Wojtekb30/ElectroChessboard/README.md

# ElectroChessboard
Electronic chessboard
