Wojtekb30/ElectroChessboard/3Dmodels/chessicons1.pdf

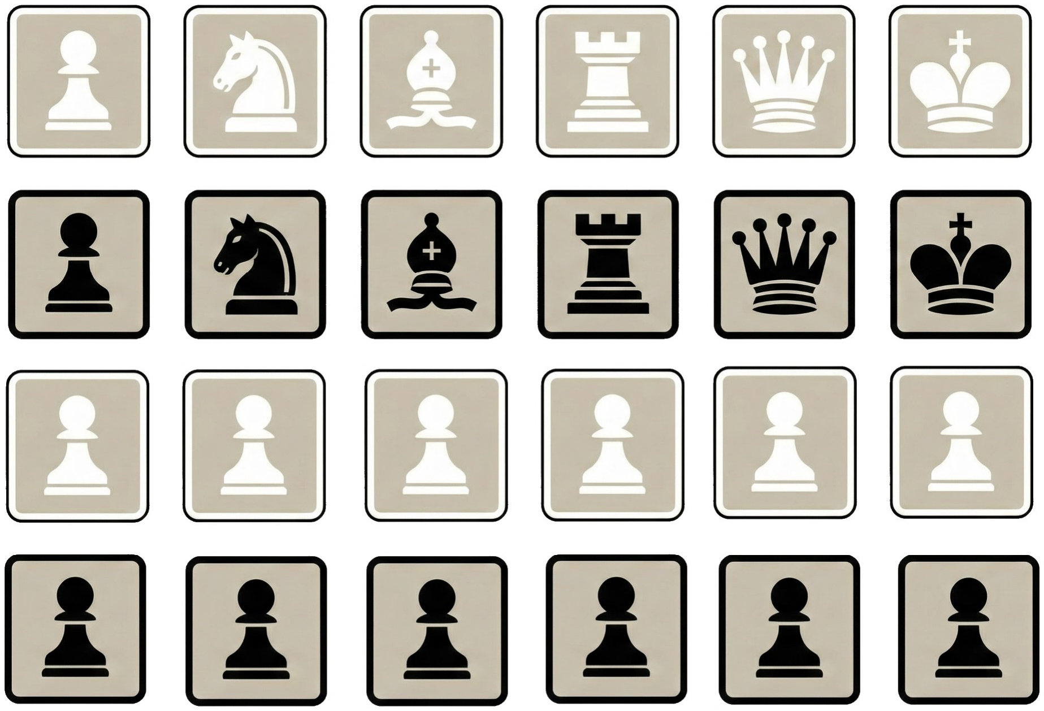
[picture p1: figure]
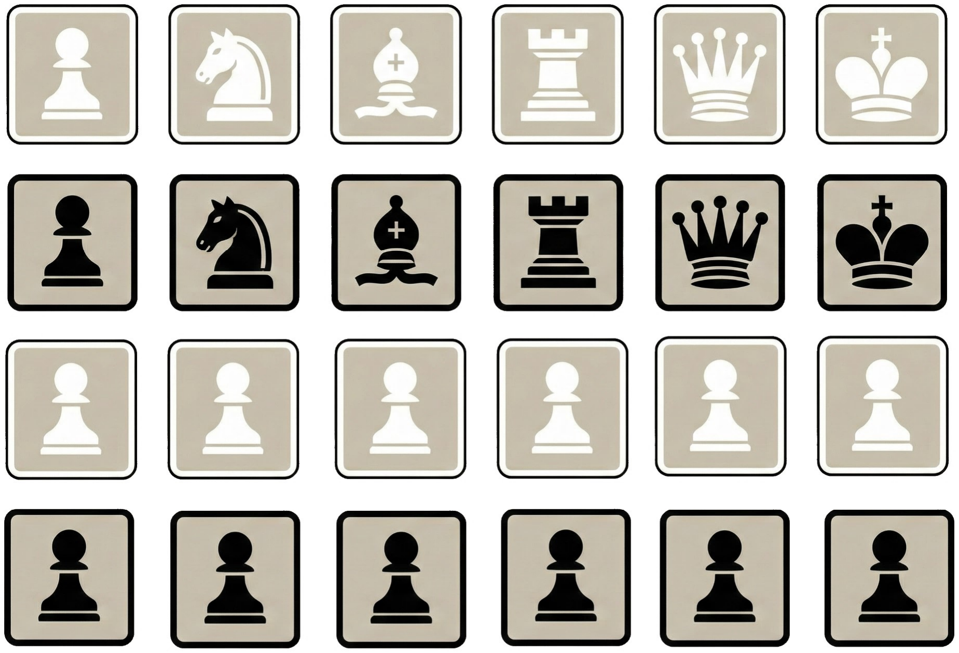
[picture p2: figure]
