Wojtekb30/ElectroChessboard/Components/PinMap2560big_Rev2.png

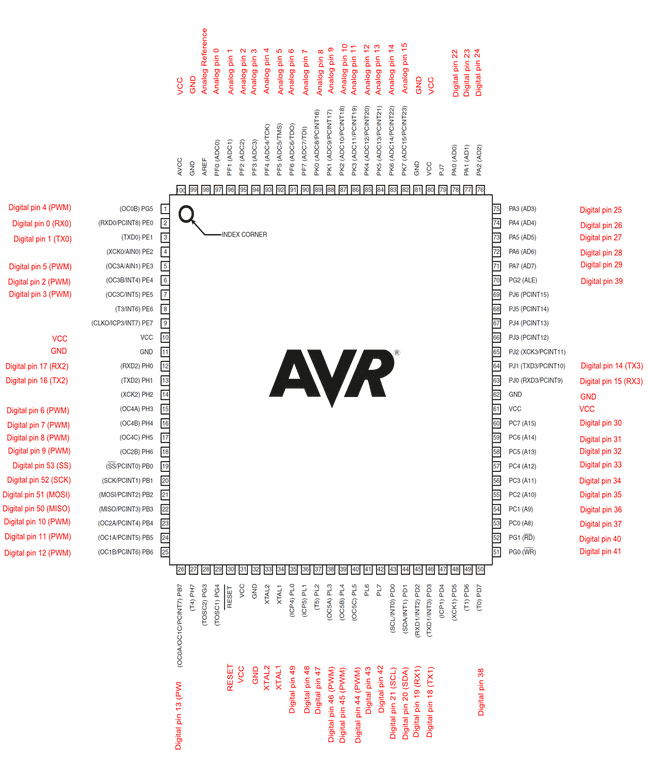
Components/PinMap2560big_Rev2.png
