Wojtekb30/ElectroChessboard/3Dmodels/16pieces1.stl

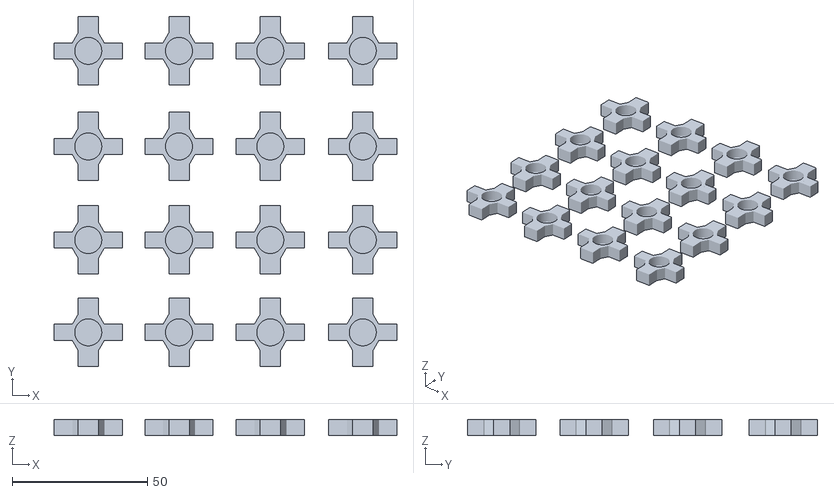
[picture p4: CAD file, 2026-01-05]
3Dmodels/16pieces1.stl
126.9 x 129.5 x 6.00
