Wojtekb30/ElectroChessboard/3Dmodels/SDcardHolderTop1.3mf

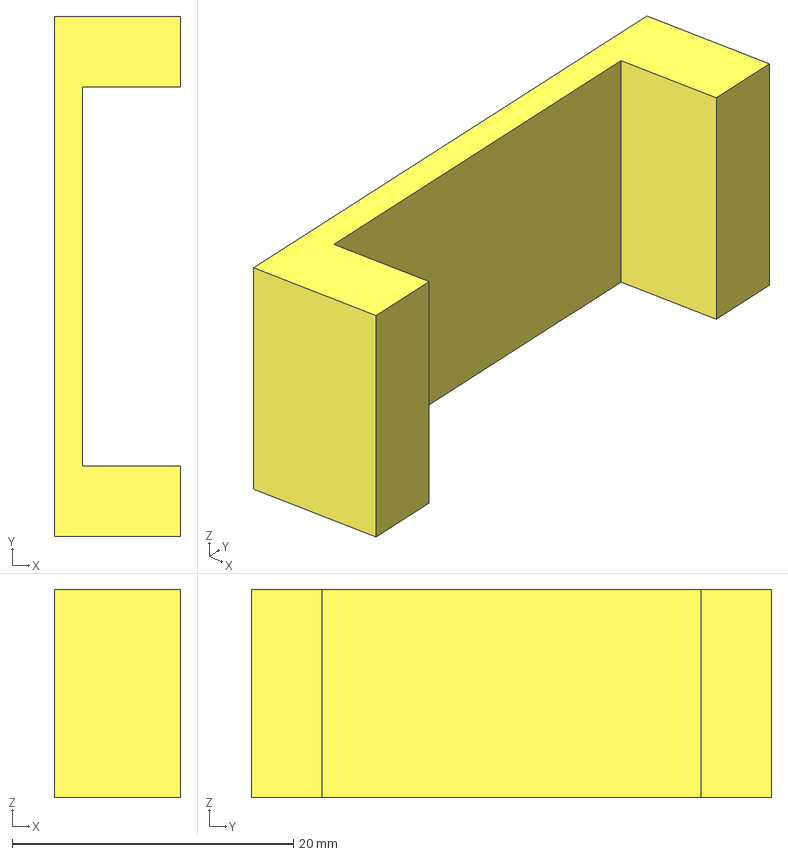
[picture p5: CAD file, 2026-01-05]
3Dmodels/SDcardHolderTop1.3mf
9.00 x 37.0 x 14.8 mm
