Wojtekb30/ElectroChessboard/3Dmodels/BoardTop1.stl

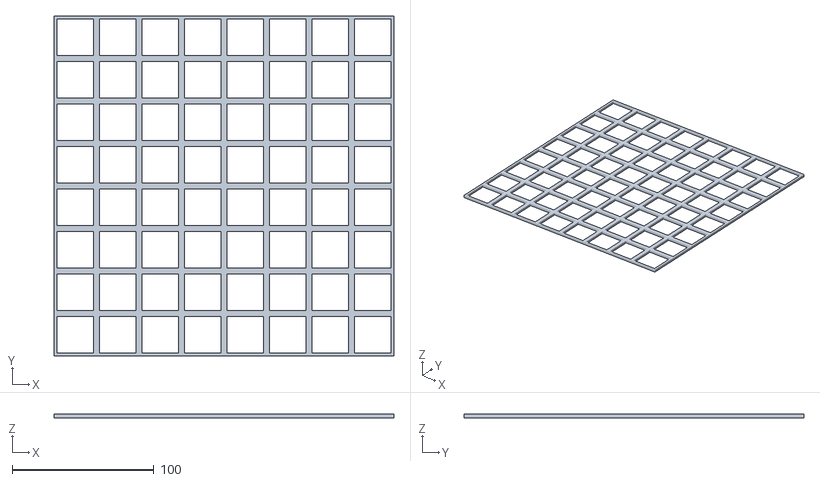
[picture p6: CAD file, 2026-01-05]
3Dmodels/BoardTop1.stl
240.0 x 240.0 x 2.50
