Wojtekb30/ElectroChessboard/3Dmodels/Piece1.3mf

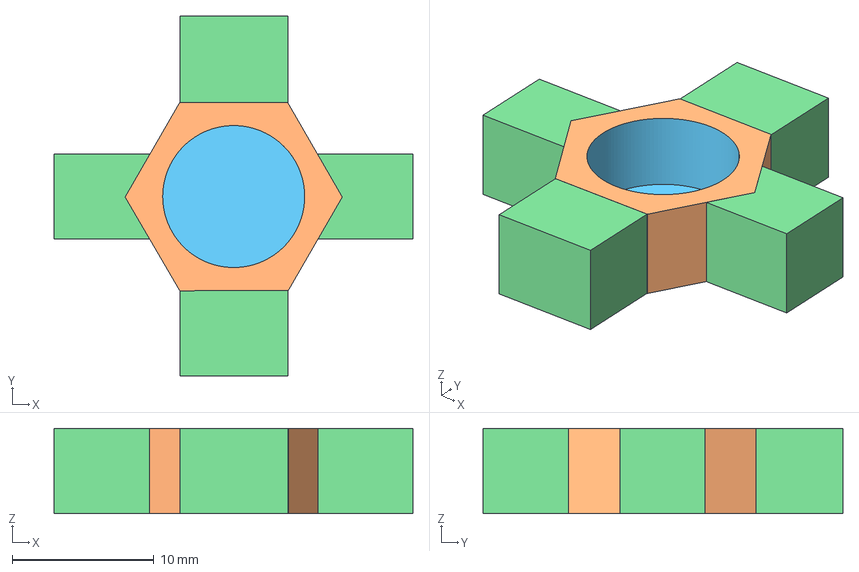
[picture p7: CAD file, 2026-01-05]
3Dmodels/Piece1.3mf
25.3 x 25.4 x 6.00 mm
