Wojtekb30/ElectroChessboard/3Dmodels/Board1.stl

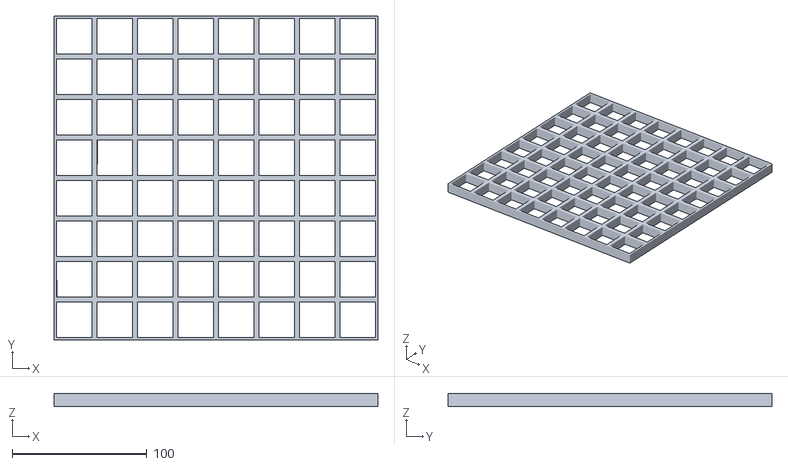
[picture p8: CAD file, 2026-01-03]
3Dmodels/Board1.stl
240.0 x 240.0 x 10.00
