Wojtekb30/ElectroChessboard/3Dmodels/BoardBase1.3mf

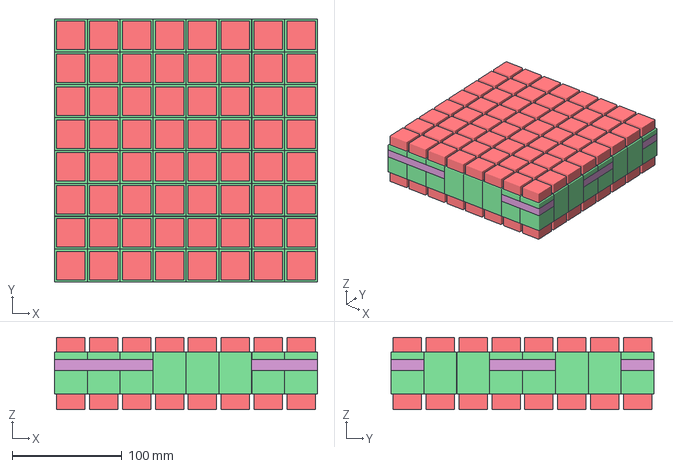
[picture p9: CAD file, 2026-01-03]
3Dmodels/BoardBase1.3mf
240.0 x 240.0 x 65.8 mm
