Wojtekb30/ElectroChessboard/(list of files, cad)

Other CAD files:
3Dmodels/Piece1.stl
3Dmodels/SDcardHolderTop1.stl
