Wojtekb30/ElectroChessboard/ElectroChessboard1/ElectroChessboard1.kicad_pcb

## KiCad design ElectroChessboard1/ElectroChessboard1.kicad_pcb (2025-12-19)

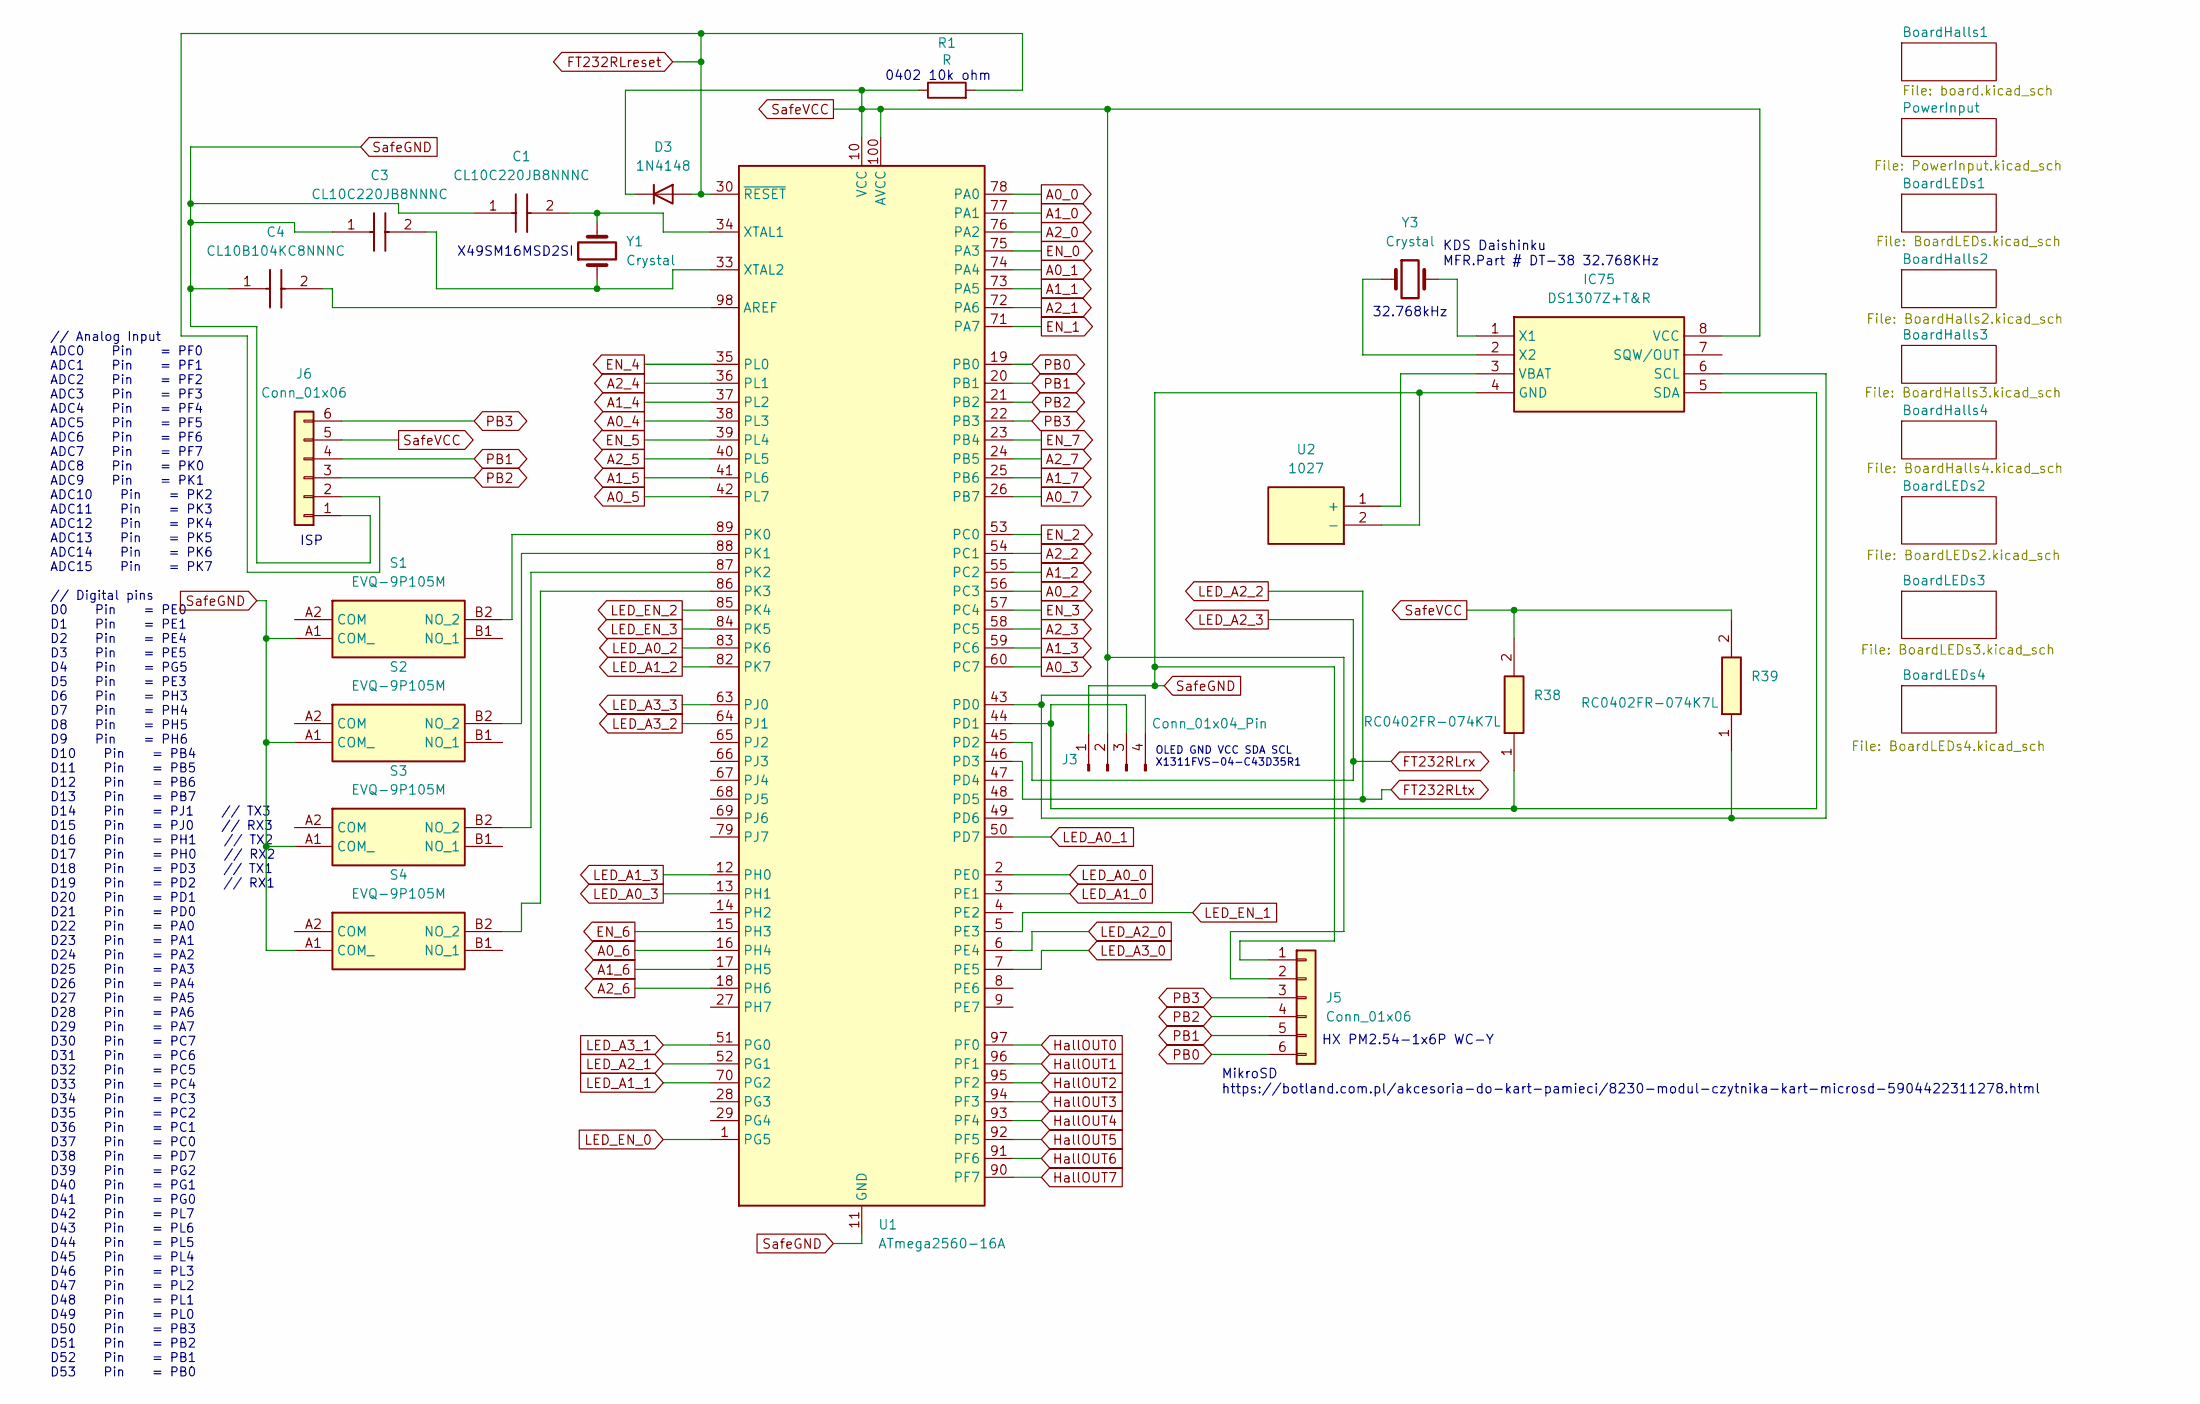
[picture p10: schematic ElectroChessboard1.kicad_sch, ElectroChessboard]

Parts:
C1, C3: CL10C220JB8NNNC; CAPC1608X90N; Mouser Part Number 187-CL10C220JB8NNNC
C4: CL10B104KC8NNNC; CAPC1608X90N; Mouser Part Number 187-CL10B104KC8NNNC
D3: 1N4148; D_SOD-123
IC75: DS1307Z+T&R; SOIC127P600X175-8N; Mouser Part Number 700-DS1307ZT&R
J3: Conn_01x04_Pin; PinSocket_1x04_P1.27mm_Vertical_SMD_Pin1Right
J5: Conn_01x06; PinSocket_1x06_P2.54mm_Horizontal
J6: Conn_01x06; PinSocket_1x06_P2.00mm_Vertical_SMD_Pin1Right
R1: R; R_0402_1005Metric
R38, R39: RC0402FR-074K7L; RESC1005X40N; Manufacturer_Part_Number RC0402FR-074K7L; Mouser Part Number 603-RC0402FR-074K7L
S1, S2, S3, S4: EVQ-9P105M; EVQ9P105M; Mouser Part Number 667-EVQ-9P105M
U1: ATmega2560-16A; TQFP-100_14x14mm_P0.5mm
U2: 1027; Mouser Part Number 534-1027
Y1: Crystal; Crystal_SMD_HC49-SD
Y3: Crystal; Crystal_C38-LF_D3.0mm_L8.0mm_Vertical

Connections:
A0_0: U1.78 (PA0); also elsewhere on the board
A0_1: U1.74 (PA4); also elsewhere on the board
A0_2: U1.56 (PC3); also elsewhere on the board
A0_3: U1.60 (PC7); also elsewhere on the board
A0_4: U1.38 (PL3); also elsewhere on the board
A0_5: U1.42 (PL7); also elsewhere on the board
A0_6: U1.16 (PH4); also elsewhere on the board
A0_7: U1.26 (PB7); also elsewhere on the board
A1_0: U1.77 (PA1); also elsewhere on the board
A1_1: U1.73 (PA5); also elsewhere on the board
A1_2: U1.55 (PC2); also elsewhere on the board
A1_3: U1.59 (PC6); also elsewhere on the board
A1_4: U1.37 (PL2); also elsewhere on the board
A1_5: U1.41 (PL6); also elsewhere on the board
A1_6: U1.17 (PH5); also elsewhere on the board
A1_7: U1.25 (PB6); also elsewhere on the board
A2_0: U1.76 (PA2); also elsewhere on the board
A2_1: U1.72 (PA6); also elsewhere on the board
A2_2: U1.54 (PC1); also elsewhere on the board
A2_3: U1.58 (PC5); also elsewhere on the board
A2_4: U1.36 (PL1); also elsewhere on the board
A2_5: U1.40 (PL5); also elsewhere on the board
A2_6: U1.18 (PH6); also elsewhere on the board
A2_7: U1.24 (PB5); also elsewhere on the board
EN_0: U1.75 (PA3); also elsewhere on the board
EN_1: U1.71 (PA7); also elsewhere on the board
EN_2: U1.53 (PC0); also elsewhere on the board
EN_3: U1.57 (PC4); also elsewhere on the board
EN_4: U1.35 (PL0); also elsewhere on the board
EN_5: U1.39 (PL4); also elsewhere on the board
EN_6: U1.15 (PH3); also elsewhere on the board
EN_7: U1.23 (PB4); also elsewhere on the board
FT232RLreset: D3.2 (A), J6.2, R1.2, U1.30 (~RESET); also elsewhere on the board
FT232RLrx: U1.45 (PD2); also elsewhere on the board
FT232RLtx: U1.46 (PD3); also elsewhere on the board
HallOUT0: U1.97 (PF0); also elsewhere on the board
HallOUT1: U1.96 (PF1); also elsewhere on the board
HallOUT2: U1.95 (PF2); also elsewhere on the board
HallOUT3: U1.94 (PF3); also elsewhere on the board
HallOUT4: U1.93 (PF4); also elsewhere on the board
HallOUT5: U1.92 (PF5); also elsewhere on the board
HallOUT6: U1.91 (PF6); also elsewhere on the board
HallOUT7: U1.90 (PF7); also elsewhere on the board
LED_A0_0: U1.2 (PE0); also elsewhere on the board
LED_A0_1: U1.50 (PD7); also elsewhere on the board
LED_A0_2: U1.83 (PK6); also elsewhere on the board
LED_A0_3: U1.13 (PH1); also elsewhere on the board
LED_A1_0: U1.3 (PE1); also elsewhere on the board
LED_A1_1: U1.70 (PG2); also elsewhere on the board
LED_A1_2: U1.82 (PK7); also elsewhere on the board
LED_A1_3: U1.12 (PH0); also elsewhere on the board
LED_A2_0: U1.6 (PE4); also elsewhere on the board
LED_A2_1: U1.52 (PG1); also elsewhere on the board
LED_A3_0: U1.7 (PE5); also elsewhere on the board
LED_A3_1: U1.51 (PG0); also elsewhere on the board
LED_A3_2: U1.64 (PJ1); also elsewhere on the board
LED_A3_3: U1.63 (PJ0); also elsewhere on the board
LED_EN_0: U1.1 (PG5); also elsewhere on the board
LED_EN_1: U1.5 (PE3); also elsewhere on the board
LED_EN_2: U1.85 (PK4); also elsewhere on the board
LED_EN_3: U1.84 (PK5); also elsewhere on the board
unnamed: IC75.6 (SCL), J3.4, R39.1, U1.43 (PD0)
unnamed: IC75.5 (SDA), J3.3, R38.1, U1.44 (PD1)
unnamed: IC75.3 (VBAT), U2.1 (+)
unnamed: IC75.1 (X1), Y3.2
unnamed: IC75.2 (X2), Y3.1
unnamed: S1.B2 (NO_2), U1.89 (PK0)
unnamed: S2.B2 (NO_2), U1.88 (PK1)
unnamed: S3.B2 (NO_2), U1.87 (PK2)
unnamed: S4.B2 (NO_2), U1.86 (PK3)
unnamed: C4.2, U1.98 (AREF)
unnamed: C1.2, U1.34 (XTAL1), Y1.2
unnamed: C3.2, U1.33 (XTAL2), Y1.1
PB0: J5.6, U1.19 (PB0)
PB1: J5.5, J6.4, U1.20 (PB1)
PB2: J5.4, J6.3, U1.21 (PB2)
PB3: J5.3, J6.6, U1.22 (PB3)
SafeGND: C1.1, C3.1, C4.1, IC75.4 (GND), J3.1, J5.1, J6.1, S1.A1 (COM_), S2.A1 (COM_), S3.A1 (COM_), S4.A1 (COM_), U1.11 (GND), U1.32 (GND), U1.62 (GND), U1.81 (GND), U1.99 (GND), U2.2 (-); also elsewhere on the board
SafeVCC: D3.1 (K), IC75.8 (VCC), J3.2, J5.2, J6.5, R1.1, R38.2, R39.2, U1.10 (VCC), U1.31 (VCC), U1.61 (VCC), U1.80 (VCC), U1.100 (AVCC); also elsewhere on the board

Notes on the sheet:
// Analog Input ADC0 Pin = PF0 ADC1 Pin = PF1 ADC2 Pin = PF2 ADC3 Pin = PF3 ADC4 Pin = PF4 ADC5 Pin = PF5 ADC6 Pin = PF6 ADC7 Pin = PF7 ADC8 Pin = PK0 ADC9 Pin = PK1 ADC10 Pin = PK2 ADC11 Pin = PK3 ADC12 Pin = PK4 ADC13 Pin = PK5 ADC14 Pin = PK6 ADC15 Pin = PK7 // Digital pins D0 Pin = PE0 D1 Pin =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
32.768kHz
X49SM16MSD2SI
0402 10k ohm
MikroSD https://botland.com.pl/akcesoria-do-kart-pamieci/8230-modul-czytnika-kart-microsd-5904422311278.html
ISP
HX PM2.54-1x6P WC-Y
KDS Daishinku MFR.Part # DT-38 32.768KHz
OLED GND VCC SDA SCL X1311FVS-04-C43D35R1

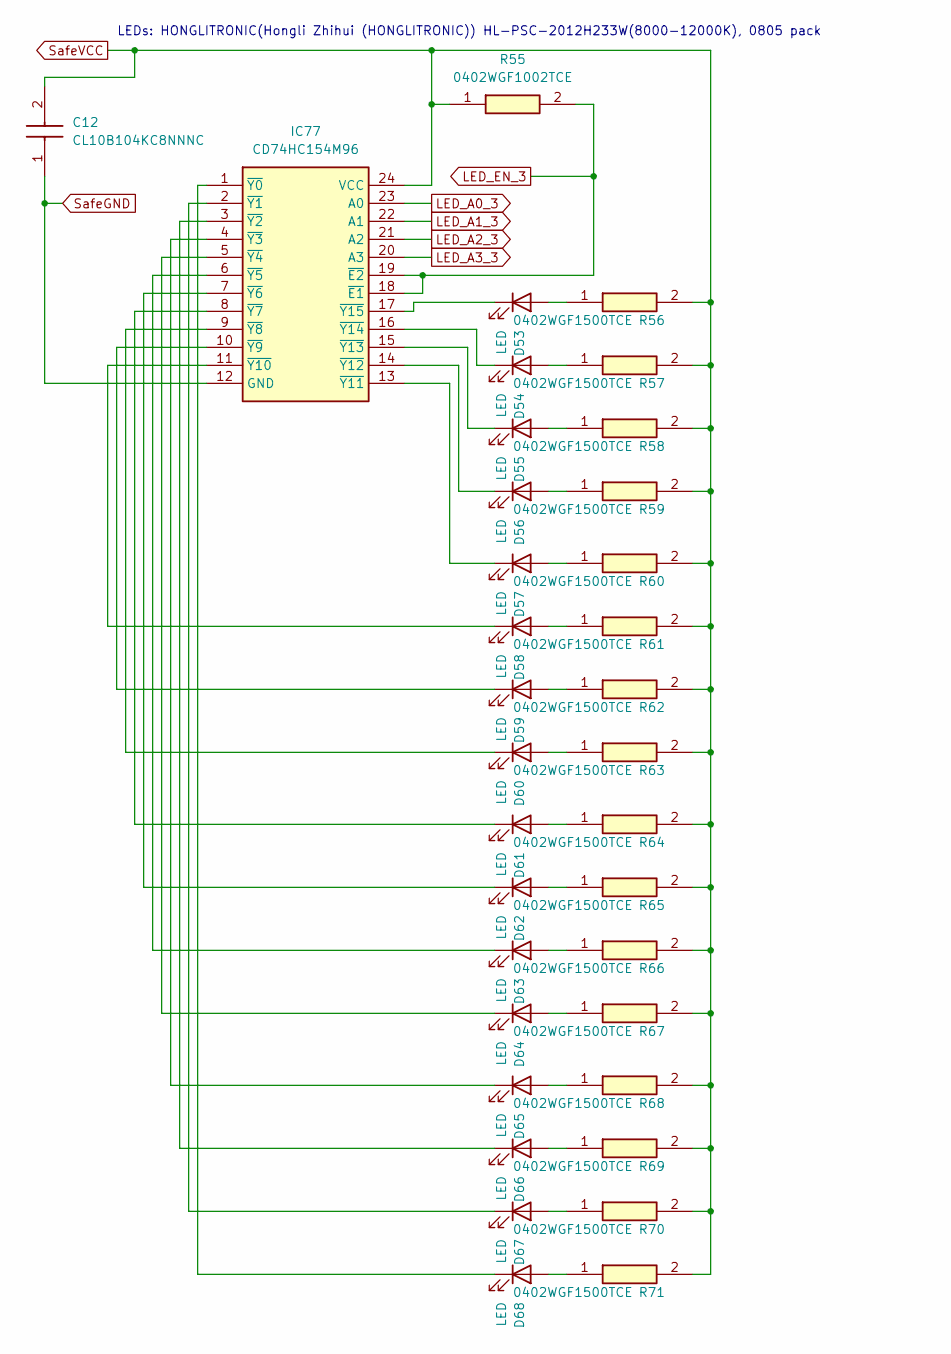
[picture p11: schematic BoardLEDs4.kicad_sch, ElectroChessboard]

Parts:
C12: CL10B104KC8NNNC; CAPC1608X90N; Mouser Part Number 187-CL10B104KC8NNNC
D53, D54, D55, D56, D57, D58, D59, D60, D61, D62, D63, D64, D65, D66, D67, D68: LED; LED_0805_2012Metric
IC77: CD74HC154M96; SOIC127P1030X265-24N; Mouser Part Number 595-CD74HC154M96
R55: 0402WGF1002TCE; RESC1005X40N; Mouser Part Number 303-0402WGF1002TCE
R56, R57, R58, R59, R60, R61, R62, R63, R64, R65, R66, R67, R68, R69, R70, R71: 0402WGF1500TCE; RESC1005X40N; Manufacturer_Part_Number 0402WGF1500TCE

Connections:
FT232RLrx: IC77.21 (A2); also elsewhere on the board
LED_A0_3: IC77.23 (A0); also elsewhere on the board
LED_A1_3: IC77.22 (A1); also elsewhere on the board
LED_A3_3: IC77.20 (A3); also elsewhere on the board
LED_EN_3: IC77.18 (~E1), IC77.19 (~E2), R55.2; also elsewhere on the board
unnamed: D53.2 (A), R56.1
unnamed: D53.1 (K), IC77.17 (~Y15)
unnamed: D54.2 (A), R57.1
unnamed: D54.1 (K), IC77.16 (~Y14)
unnamed: D55.2 (A), R58.1
unnamed: D55.1 (K), IC77.15 (~Y13)
unnamed: D56.2 (A), R59.1
unnamed: D56.1 (K), IC77.14 (~Y12)
unnamed: D57.2 (A), R60.1
unnamed: D57.1 (K), IC77.13 (~Y11)
unnamed: D58.2 (A), R61.1
unnamed: D58.1 (K), IC77.11 (~Y10)
unnamed: D59.2 (A), R62.1
unnamed: D59.1 (K), IC77.10 (~Y9)
unnamed: D60.2 (A), R63.1
unnamed: D60.1 (K), IC77.9 (~Y8)
unnamed: D61.2 (A), R64.1
unnamed: D61.1 (K), IC77.8 (~Y7)
unnamed: D62.2 (A), R65.1
unnamed: D62.1 (K), IC77.7 (~Y6)
unnamed: D63.2 (A), R66.1
unnamed: D63.1 (K), IC77.6 (~Y5)
unnamed: D64.2 (A), R67.1
unnamed: D64.1 (K), IC77.5 (~Y4)
unnamed: D65.2 (A), R68.1
unnamed: D65.1 (K), IC77.4 (~Y3)
unnamed: D66.2 (A), R69.1
unnamed: D66.1 (K), IC77.3 (~Y2)
unnamed: D67.2 (A), R70.1
unnamed: D67.1 (K), IC77.2 (~Y1)
unnamed: D68.2 (A), R71.1
unnamed: D68.1 (K), IC77.1 (~Y0)
SafeGND: C12.1, IC77.12 (GND); also elsewhere on the board
SafeVCC: C12.2, IC77.24 (VCC), R55.1, R56.2, R57.2, R58.2, R59.2, R60.2, R61.2, R62.2, R63.2, R64.2, R65.2, R66.2, R67.2, R68.2, R69.2, R70.2, R71.2; also elsewhere on the board

Notes on the sheet:
LEDs: HONGLITRONIC(Hongli Zhihui (HONGLITRONIC)) HL-PSC-2012H233W(8000-12000K), 0805 pack

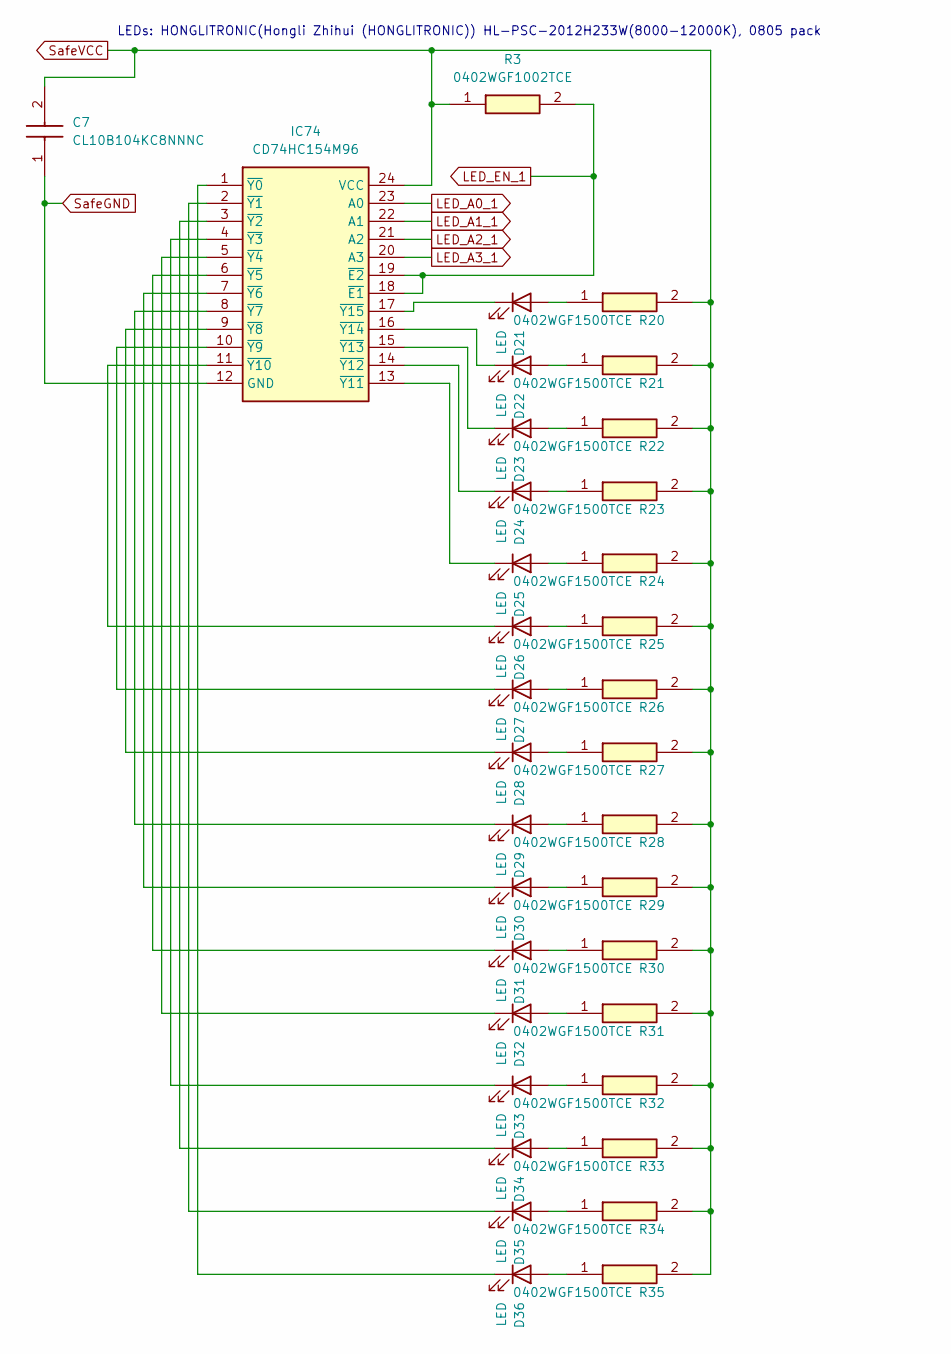
[picture p12: schematic BoardLEDs2.kicad_sch, ElectroChessboard]

Parts:
C7: CL10B104KC8NNNC; CAPC1608X90N; Mouser Part Number 187-CL10B104KC8NNNC
D21, D22, D23, D24, D25, D26, D27, D28, D29, D30, D31, D32, D33, D34, D35, D36: LED; LED_0805_2012Metric
IC74: CD74HC154M96; SOIC127P1030X265-24N; Mouser Part Number 595-CD74HC154M96
R3: 0402WGF1002TCE; RESC1005X40N; Mouser Part Number 303-0402WGF1002TCE
R20, R21, R22, R23, R24, R25, R26, R27, R28, R29, R30, R31, R32, R33, R34, R35: 0402WGF1500TCE; RESC1005X40N; Manufacturer_Part_Number 0402WGF1500TCE

Connections:
LED_A0_1: IC74.23 (A0); also elsewhere on the board
LED_A1_1: IC74.22 (A1); also elsewhere on the board
LED_A2_1: IC74.21 (A2); also elsewhere on the board
LED_A3_1: IC74.20 (A3); also elsewhere on the board
LED_EN_1: IC74.18 (~E1), IC74.19 (~E2), R3.2; also elsewhere on the board
unnamed: D21.2 (A), R20.1
unnamed: D21.1 (K), IC74.17 (~Y15)
unnamed: D22.2 (A), R21.1
unnamed: D22.1 (K), IC74.16 (~Y14)
unnamed: D23.2 (A), R22.1
unnamed: D23.1 (K), IC74.15 (~Y13)
unnamed: D24.2 (A), R23.1
unnamed: D24.1 (K), IC74.14 (~Y12)
unnamed: D25.2 (A), R24.1
unnamed: D25.1 (K), IC74.13 (~Y11)
unnamed: D26.2 (A), R25.1
unnamed: D26.1 (K), IC74.11 (~Y10)
unnamed: D27.2 (A), R26.1
unnamed: D27.1 (K), IC74.10 (~Y9)
unnamed: D28.2 (A), R27.1
unnamed: D28.1 (K), IC74.9 (~Y8)
unnamed: D29.2 (A), R28.1
unnamed: D29.1 (K), IC74.8 (~Y7)
unnamed: D30.2 (A), R29.1
unnamed: D30.1 (K), IC74.7 (~Y6)
unnamed: D31.2 (A), R30.1
unnamed: D31.1 (K), IC74.6 (~Y5)
unnamed: D32.2 (A), R31.1
unnamed: D32.1 (K), IC74.5 (~Y4)
unnamed: D33.2 (A), R32.1
unnamed: D33.1 (K), IC74.4 (~Y3)
unnamed: D34.2 (A), R33.1
unnamed: D34.1 (K), IC74.3 (~Y2)
unnamed: D35.2 (A), R34.1
unnamed: D35.1 (K), IC74.2 (~Y1)
unnamed: D36.2 (A), R35.1
unnamed: D36.1 (K), IC74.1 (~Y0)
SafeGND: C7.1, IC74.12 (GND); also elsewhere on the board
SafeVCC: C7.2, IC74.24 (VCC), R3.1, R20.2, R21.2, R22.2, R23.2, R24.2, R25.2, R26.2, R27.2, R28.2, R29.2, R30.2, R31.2, R32.2, R33.2, R34.2, R35.2; also elsewhere on the board

Notes on the sheet:
LEDs: HONGLITRONIC(Hongli Zhihui (HONGLITRONIC)) HL-PSC-2012H233W(8000-12000K), 0805 pack

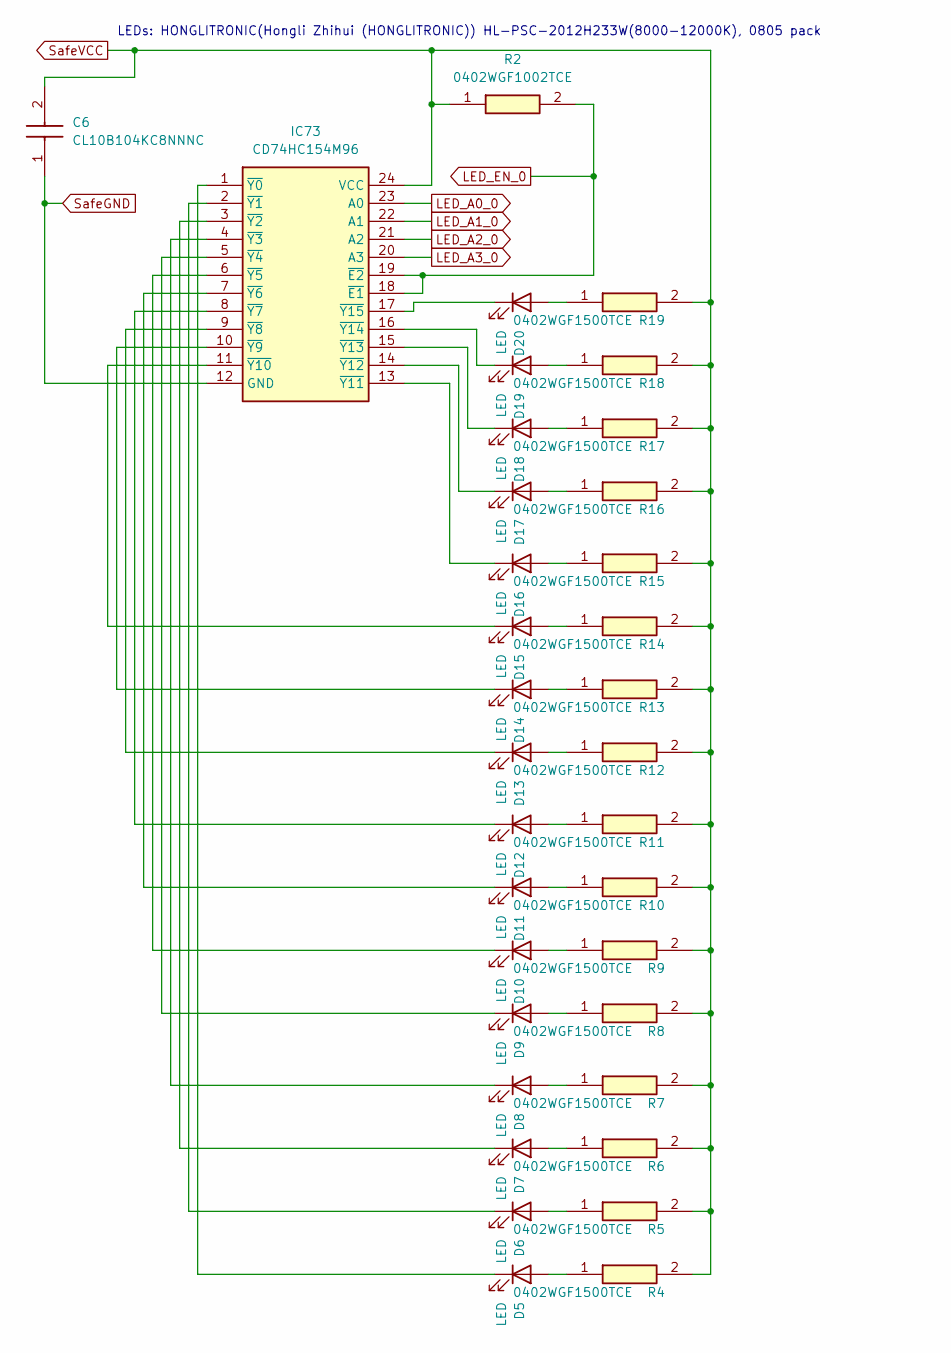
[picture p13: schematic BoardLEDs.kicad_sch, ElectroChessboard]

Parts:
C6: CL10B104KC8NNNC; CAPC1608X90N; Mouser Part Number 187-CL10B104KC8NNNC
D5, D6, D7, D8, D9, D10, D11, D12, D13, D14, D15, D16, D17, D18, D19, D20: LED; LED_0805_2012Metric
IC73: CD74HC154M96; SOIC127P1030X265-24N; Mouser Part Number 595-CD74HC154M96
R2: 0402WGF1002TCE; RESC1005X40N; Mouser Part Number 303-0402WGF1002TCE
R4, R5, R6, R7, R8, R9, R10, R11, R12, R13, R14, R15, R16, R17, R18, R19: 0402WGF1500TCE; RESC1005X40N; Manufacturer_Part_Number 0402WGF1500TCE

Connections:
LED_A0_0: IC73.23 (A0); also elsewhere on the board
LED_A1_0: IC73.22 (A1); also elsewhere on the board
LED_A2_0: IC73.21 (A2); also elsewhere on the board
LED_A3_0: IC73.20 (A3); also elsewhere on the board
LED_EN_0: IC73.18 (~E1), IC73.19 (~E2), R2.2; also elsewhere on the board
unnamed: D5.2 (A), R4.1
unnamed: D5.1 (K), IC73.1 (~Y0)
unnamed: D6.2 (A), R5.1
unnamed: D6.1 (K), IC73.2 (~Y1)
unnamed: D7.2 (A), R6.1
unnamed: D7.1 (K), IC73.3 (~Y2)
unnamed: D8.2 (A), R7.1
unnamed: D8.1 (K), IC73.4 (~Y3)
unnamed: D9.2 (A), R8.1
unnamed: D9.1 (K), IC73.5 (~Y4)
unnamed: D10.2 (A), R9.1
unnamed: D10.1 (K), IC73.6 (~Y5)
unnamed: D11.2 (A), R10.1
unnamed: D11.1 (K), IC73.7 (~Y6)
unnamed: D12.2 (A), R11.1
unnamed: D12.1 (K), IC73.8 (~Y7)
unnamed: D13.2 (A), R12.1
unnamed: D13.1 (K), IC73.9 (~Y8)
unnamed: D14.2 (A), R13.1
unnamed: D14.1 (K), IC73.10 (~Y9)
unnamed: D15.2 (A), R14.1
unnamed: D15.1 (K), IC73.11 (~Y10)
unnamed: D16.2 (A), R15.1
unnamed: D16.1 (K), IC73.13 (~Y11)
unnamed: D17.2 (A), R16.1
unnamed: D17.1 (K), IC73.14 (~Y12)
unnamed: D18.2 (A), R17.1
unnamed: D18.1 (K), IC73.15 (~Y13)
unnamed: D19.2 (A), R18.1
unnamed: D19.1 (K), IC73.16 (~Y14)
unnamed: D20.2 (A), R19.1
unnamed: D20.1 (K), IC73.17 (~Y15)
SafeGND: C6.1, IC73.12 (GND); also elsewhere on the board
SafeVCC: C6.2, IC73.24 (VCC), R2.1, R4.2, R5.2, R6.2, R7.2, R8.2, R9.2, R10.2, R11.2, R12.2, R13.2, R14.2, R15.2, R16.2, R17.2, R18.2, R19.2; also elsewhere on the board

Notes on the sheet:
LEDs: HONGLITRONIC(Hongli Zhihui (HONGLITRONIC)) HL-PSC-2012H233W(8000-12000K), 0805 pack

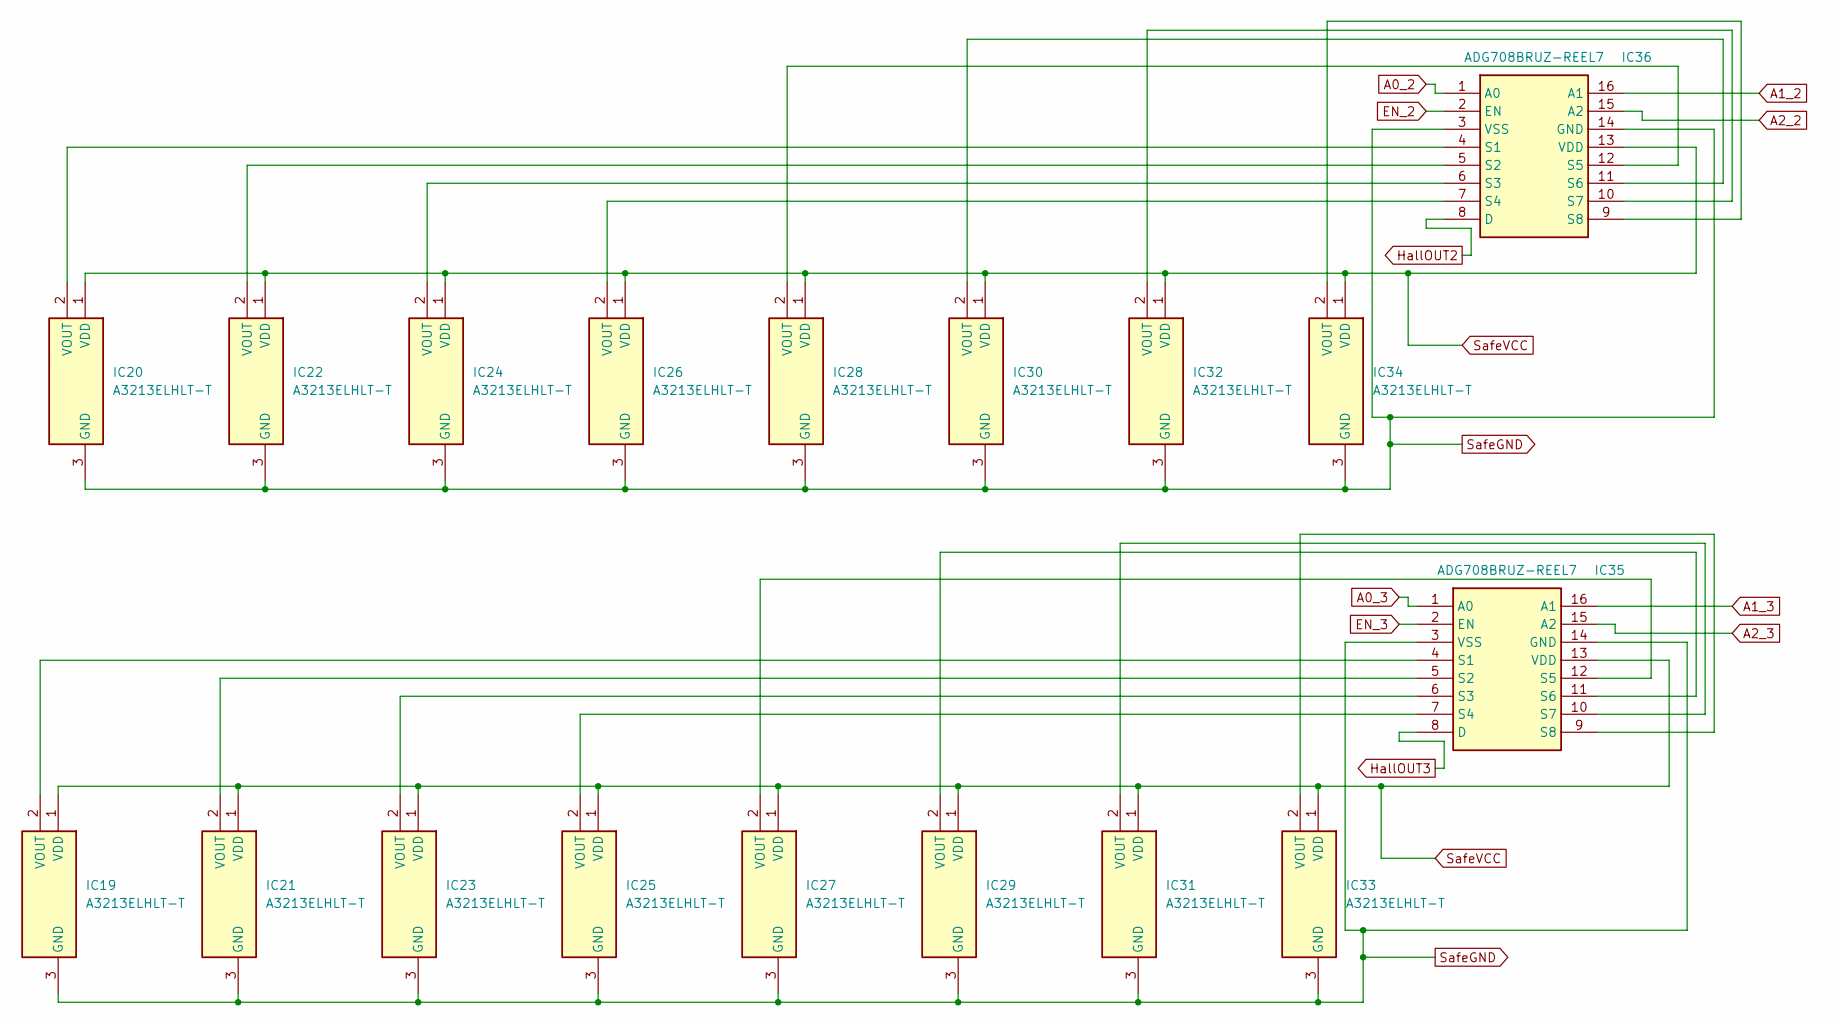
[picture p14: schematic BoardHalls2.kicad_sch, ElectroChessboard]

Parts:
IC19, IC20, IC21, IC22, IC23, IC24, IC25, IC26, IC27, IC28, IC29, IC30, IC31, IC32, IC33, IC34: A3213ELHLT-T; A3213ELHLTT; Mouser Part Number 250-A3213ELHLT-T
IC35, IC36: ADG708BRUZ-REEL7; SOP65P640X120-16N; Mouser Part Number 584-ADG708BRUZ-R7

Connections:
A0_2: IC36.1 (A0); also elsewhere on the board
A0_3: IC35.1 (A0); also elsewhere on the board
A1_2: IC36.16 (A1); also elsewhere on the board
A1_3: IC35.16 (A1); also elsewhere on the board
A2_2: IC36.15 (A2); also elsewhere on the board
A2_3: IC35.15 (A2); also elsewhere on the board
EN_2: IC36.2 (EN); also elsewhere on the board
EN_3: IC35.2 (EN); also elsewhere on the board
HallOUT2: IC36.8 (D); also elsewhere on the board
HallOUT3: IC35.8 (D); also elsewhere on the board
unnamed: IC19.2 (VOUT), IC35.4 (S1)
unnamed: IC20.2 (VOUT), IC36.4 (S1)
unnamed: IC21.2 (VOUT), IC35.5 (S2)
unnamed: IC22.2 (VOUT), IC36.5 (S2)
unnamed: IC23.2 (VOUT), IC35.6 (S3)
unnamed: IC24.2 (VOUT), IC36.6 (S3)
unnamed: IC25.2 (VOUT), IC35.7 (S4)
unnamed: IC26.2 (VOUT), IC36.7 (S4)
unnamed: IC27.2 (VOUT), IC35.12 (S5)
unnamed: IC28.2 (VOUT), IC36.12 (S5)
unnamed: IC29.2 (VOUT), IC35.11 (S6)
unnamed: IC30.2 (VOUT), IC36.11 (S6)
unnamed: IC31.2 (VOUT), IC35.10 (S7)
unnamed: IC32.2 (VOUT), IC36.10 (S7)
unnamed: IC33.2 (VOUT), IC35.9 (S8)
unnamed: IC34.2 (VOUT), IC36.9 (S8)
SafeGND: IC19.3 (GND), IC20.3 (GND), IC21.3 (GND), IC22.3 (GND), IC23.3 (GND), IC24.3 (GND), IC25.3 (GND), IC26.3 (GND), IC27.3 (GND), IC28.3 (GND), IC29.3 (GND), IC30.3 (GND), IC31.3 (GND), IC32.3 (GND), IC33.3 (GND), IC34.3 (GND), IC35.3 (VSS), IC35.14 (GND), IC36.3 (VSS), IC36.14 (GND); also elsewhere on the board
SafeVCC: IC19.1 (VDD), IC20.1 (VDD), IC21.1 (VDD), IC22.1 (VDD), IC23.1 (VDD), IC24.1 (VDD), IC25.1 (VDD), IC26.1 (VDD), IC27.1 (VDD), IC28.1 (VDD), IC29.1 (VDD), IC30.1 (VDD), IC31.1 (VDD), IC32.1 (VDD), IC33.1 (VDD), IC34.1 (VDD), IC35.13 (VDD), IC36.13 (VDD); also elsewhere on the board

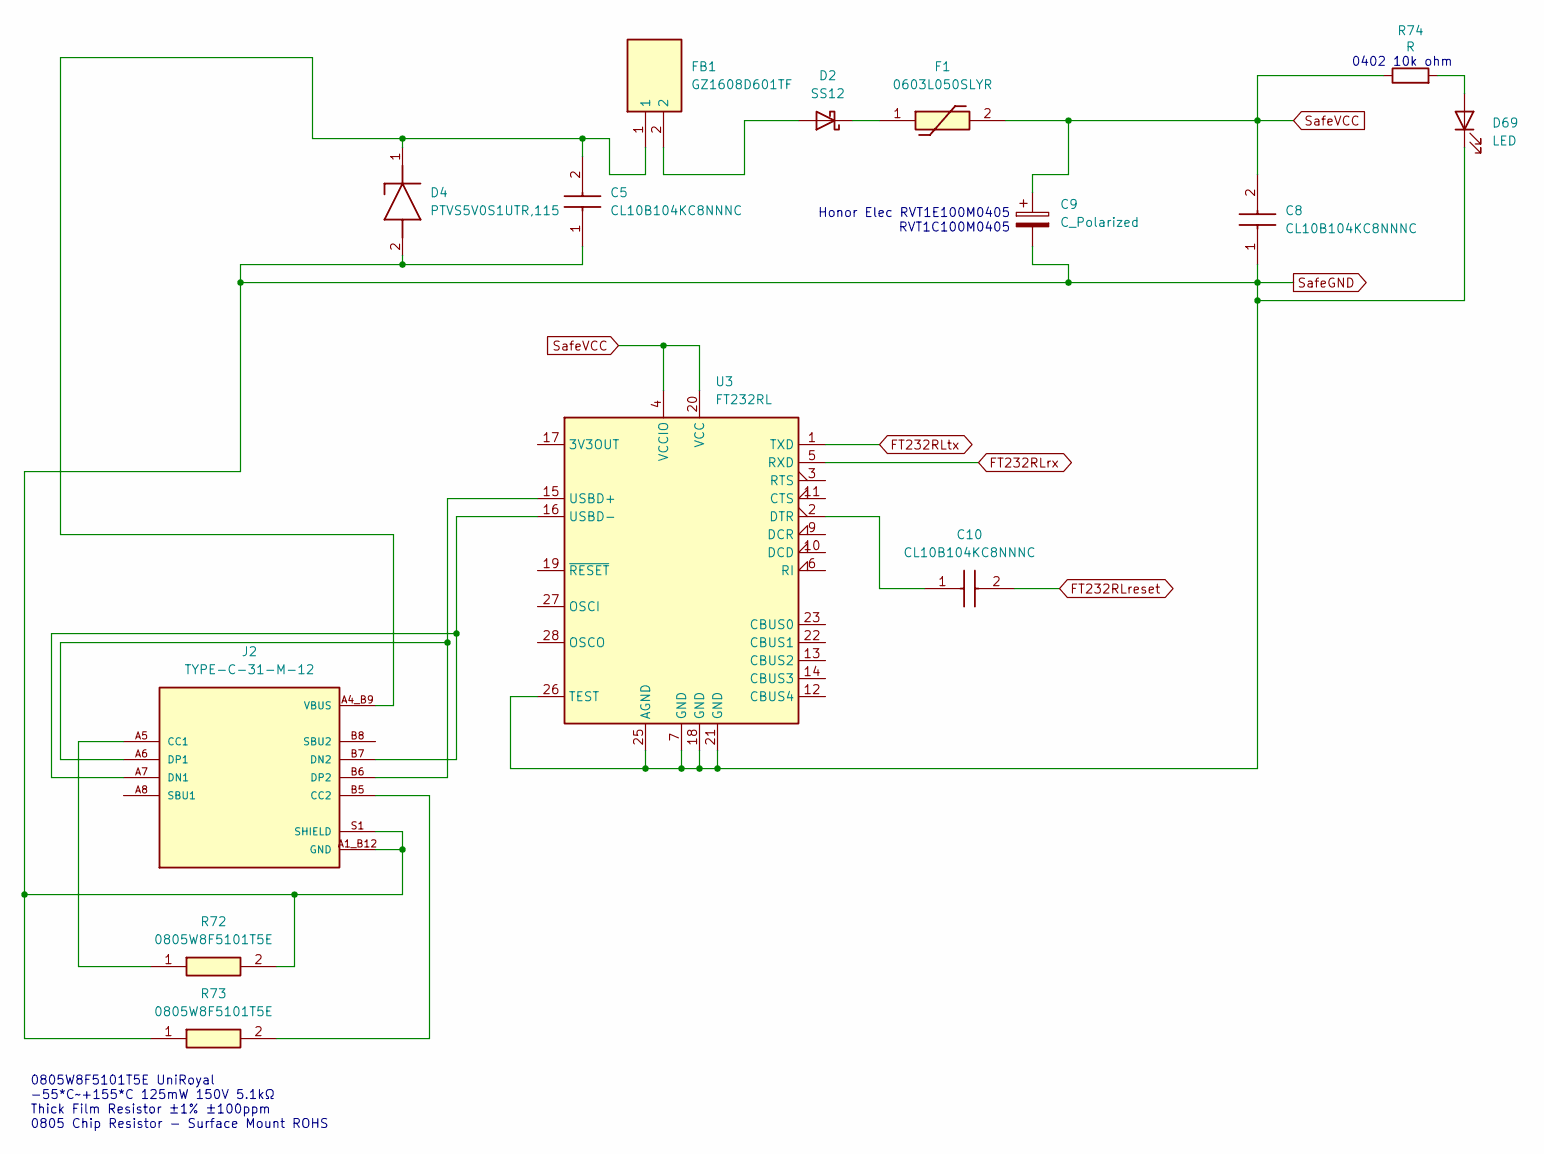
[picture p15: schematic PowerInput.kicad_sch, ElectroChessboard]

Parts:
C5, C8, C10: CL10B104KC8NNNC; CAPC1608X90N; Mouser Part Number 187-CL10B104KC8NNNC
C9: C_Polarized; CP_Elec_4x5.4
D2: SS12; D_SMA
D4: PTVS5V0S1UTR,115; SOD123W; Mouser Part Number 771-PTVS5V0S1UTR115
D69: LED; LED_0805_2012Metric
F1: 0603L050SLYR; Mouser Part Number 576-0603L050SLYR
FB1: GZ1608D601TF; BEADC1608X95N; Manufacturer_Part_Number GZ1608D601TF
J2: TYPE-C-31-M-12; HRO_TYPE-C-31-M-12; PARTREV 2020.12.08
R72, R73: 0805W8F5101T5E; RESC2013X65N; Manufacturer_Part_Number 0805W8F5101T5E
R74: R; R_0402_1005Metric
U3: FT232RL; SSOP-28_5.3x10.2mm_P0.65mm

Connections:
FT232RLreset: C10.2; also elsewhere on the board
FT232RLrx: U3.5 (RXD); also elsewhere on the board
FT232RLtx: U3.1 (TXD); also elsewhere on the board
unnamed: D2.2 (A), FB1.2
unnamed: D2.1 (K), F1.1
unnamed: D69.2 (A), R74.2
unnamed: J2.A5 (CC1), R72.1
unnamed: J2.B5 (CC2), R73.2
unnamed: J2.A7 (DN1), J2.B7 (DN2), U3.16 (USBD-)
unnamed: J2.A6 (DP1), J2.B6 (DP2), U3.15 (USBD+)
unnamed: C10.1, U3.2 (DTR)
SafeGND: C5.1, C8.1, C9.2, D4.2 (A), D69.1 (K), J2.A1_B12 (GND), J2.B1_A12 (GND), J2.S1 (SHIELD), J2.S2 (SHIELD), J2.S3 (SHIELD), J2.S4 (SHIELD), R72.2, R73.1, U3.7 (GND), U3.18 (GND), U3.21 (GND), U3.25 (AGND), U3.26 (TEST); also elsewhere on the board
SafeVCC: C8.2, C9.1, F1.2, R74.1, U3.4 (VCCIO), U3.20 (VCC); also elsewhere on the board
VBUS: C5.2, D4.1 (K), FB1.1, J2.A4_B9 (VBUS), J2.B4_A9 (VBUS)

Notes on the sheet:
0402 10k ohm
Honor Elec RVT1E100M0405 RVT1C100M0405
0805W8F5101T5E UniRoyal -55*C~+155*C 125mW 150V 5.1kΩ Thick Film Resistor ±1% ±100ppm 0805 Chip Resistor - Surface Mount ROHS

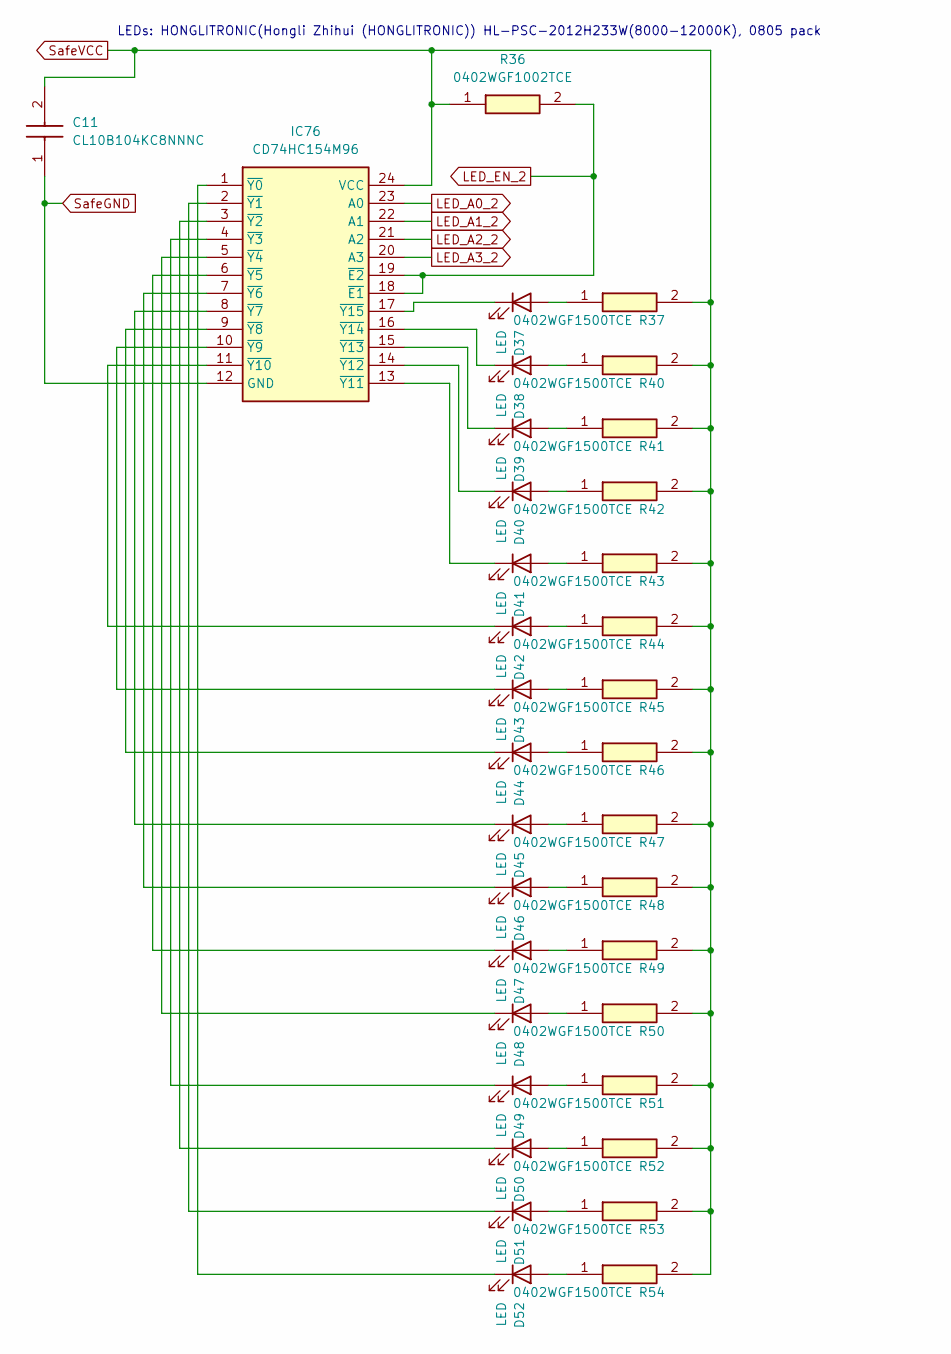
[picture p16: schematic BoardLEDs3.kicad_sch, ElectroChessboard]

Parts:
C11: CL10B104KC8NNNC; CAPC1608X90N; Mouser Part Number 187-CL10B104KC8NNNC
D37, D38, D39, D40, D41, D42, D43, D44, D45, D46, D47, D48, D49, D50, D51, D52: LED; LED_0805_2012Metric
IC76: CD74HC154M96; SOIC127P1030X265-24N; Mouser Part Number 595-CD74HC154M96
R36: 0402WGF1002TCE; RESC1005X40N; Mouser Part Number 303-0402WGF1002TCE
R37, R40, R41, R42, R43, R44, R45, R46, R47, R48, R49, R50, R51, R52, R53, R54: 0402WGF1500TCE; RESC1005X40N; Manufacturer_Part_Number 0402WGF1500TCE

Connections:
FT232RLtx: IC76.21 (A2); also elsewhere on the board
LED_A0_2: IC76.23 (A0); also elsewhere on the board
LED_A1_2: IC76.22 (A1); also elsewhere on the board
LED_A3_2: IC76.20 (A3); also elsewhere on the board
LED_EN_2: IC76.18 (~E1), IC76.19 (~E2), R36.2; also elsewhere on the board
unnamed: D37.2 (A), R37.1
unnamed: D37.1 (K), IC76.17 (~Y15)
unnamed: D38.2 (A), R40.1
unnamed: D38.1 (K), IC76.16 (~Y14)
unnamed: D39.2 (A), R41.1
unnamed: D39.1 (K), IC76.15 (~Y13)
unnamed: D40.2 (A), R42.1
unnamed: D40.1 (K), IC76.14 (~Y12)
unnamed: D41.2 (A), R43.1
unnamed: D41.1 (K), IC76.13 (~Y11)
unnamed: D42.2 (A), R44.1
unnamed: D42.1 (K), IC76.11 (~Y10)
unnamed: D43.2 (A), R45.1
unnamed: D43.1 (K), IC76.10 (~Y9)
unnamed: D44.2 (A), R46.1
unnamed: D44.1 (K), IC76.9 (~Y8)
unnamed: D45.2 (A), R47.1
unnamed: D45.1 (K), IC76.8 (~Y7)
unnamed: D46.2 (A), R48.1
unnamed: D46.1 (K), IC76.7 (~Y6)
unnamed: D47.2 (A), R49.1
unnamed: D47.1 (K), IC76.6 (~Y5)
unnamed: D48.2 (A), R50.1
unnamed: D48.1 (K), IC76.5 (~Y4)
unnamed: D49.2 (A), R51.1
unnamed: D49.1 (K), IC76.4 (~Y3)
unnamed: D50.2 (A), R52.1
unnamed: D50.1 (K), IC76.3 (~Y2)
unnamed: D51.2 (A), R53.1
unnamed: D51.1 (K), IC76.2 (~Y1)
unnamed: D52.2 (A), R54.1
unnamed: D52.1 (K), IC76.1 (~Y0)
SafeGND: C11.1, IC76.12 (GND); also elsewhere on the board
SafeVCC: C11.2, IC76.24 (VCC), R36.1, R37.2, R40.2, R41.2, R42.2, R43.2, R44.2, R45.2, R46.2, R47.2, R48.2, R49.2, R50.2, R51.2, R52.2, R53.2, R54.2; also elsewhere on the board

Notes on the sheet:
LEDs: HONGLITRONIC(Hongli Zhihui (HONGLITRONIC)) HL-PSC-2012H233W(8000-12000K), 0805 pack
