Wojtekb30/ElectroChessboard/ElectroChessboard1/ElectroChessboard1.kicad_pcb

## KiCad design ElectroChessboard1/ElectroChessboard1.kicad_pcb (continued)

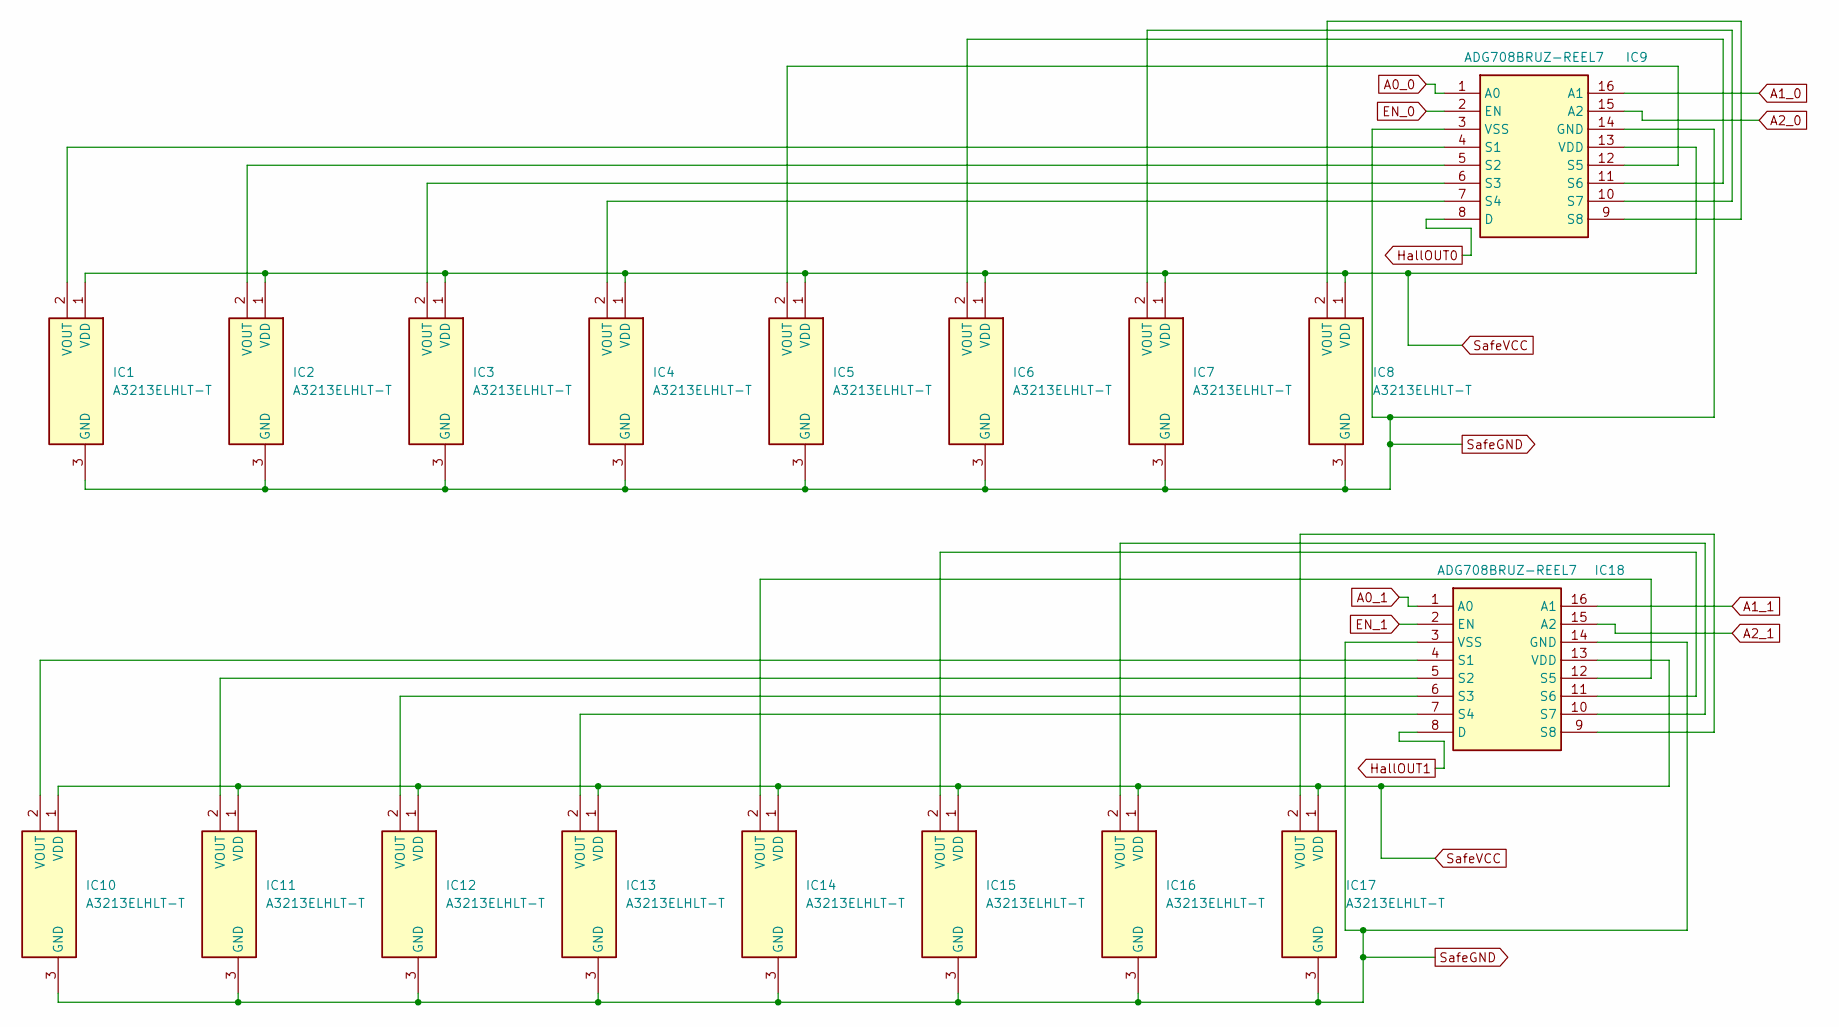
[picture p17: schematic board.kicad_sch, ElectroChessboard]

Parts:
IC1, IC2, IC3, IC4, IC5, IC6, IC7, IC8, IC10, IC11, IC12, IC13, IC14, IC15, IC16, IC17: A3213ELHLT-T; A3213ELHLTT; Mouser Part Number 250-A3213ELHLT-T
IC9, IC18: ADG708BRUZ-REEL7; SOP65P640X120-16N; Mouser Part Number 584-ADG708BRUZ-R7

Connections:
A0_0: IC9.1 (A0); also elsewhere on the board
A0_1: IC18.1 (A0); also elsewhere on the board
A1_0: IC9.16 (A1); also elsewhere on the board
A1_1: IC18.16 (A1); also elsewhere on the board
A2_0: IC9.15 (A2); also elsewhere on the board
A2_1: IC18.15 (A2); also elsewhere on the board
EN_0: IC9.2 (EN); also elsewhere on the board
EN_1: IC18.2 (EN); also elsewhere on the board
HallOUT0: IC9.8 (D); also elsewhere on the board
HallOUT1: IC18.8 (D); also elsewhere on the board
unnamed: IC1.2 (VOUT), IC9.4 (S1)
unnamed: IC2.2 (VOUT), IC9.5 (S2)
unnamed: IC3.2 (VOUT), IC9.6 (S3)
unnamed: IC4.2 (VOUT), IC9.7 (S4)
unnamed: IC5.2 (VOUT), IC9.12 (S5)
unnamed: IC6.2 (VOUT), IC9.11 (S6)
unnamed: IC7.2 (VOUT), IC9.10 (S7)
unnamed: IC8.2 (VOUT), IC9.9 (S8)
unnamed: IC10.2 (VOUT), IC18.4 (S1)
unnamed: IC11.2 (VOUT), IC18.5 (S2)
unnamed: IC12.2 (VOUT), IC18.6 (S3)
unnamed: IC13.2 (VOUT), IC18.7 (S4)
unnamed: IC14.2 (VOUT), IC18.12 (S5)
unnamed: IC15.2 (VOUT), IC18.11 (S6)
unnamed: IC16.2 (VOUT), IC18.10 (S7)
unnamed: IC17.2 (VOUT), IC18.9 (S8)
SafeGND: IC1.3 (GND), IC2.3 (GND), IC3.3 (GND), IC4.3 (GND), IC5.3 (GND), IC6.3 (GND), IC7.3 (GND), IC8.3 (GND), IC9.3 (VSS), IC9.14 (GND), IC10.3 (GND), IC11.3 (GND), IC12.3 (GND), IC13.3 (GND), IC14.3 (GND), IC15.3 (GND), IC16.3 (GND), IC17.3 (GND), IC18.3 (VSS), IC18.14 (GND); also elsewhere on the board
SafeVCC: IC1.1 (VDD), IC2.1 (VDD), IC3.1 (VDD), IC4.1 (VDD), IC5.1 (VDD), IC6.1 (VDD), IC7.1 (VDD), IC8.1 (VDD), IC9.13 (VDD), IC10.1 (VDD), IC11.1 (VDD), IC12.1 (VDD), IC13.1 (VDD), IC14.1 (VDD), IC15.1 (VDD), IC16.1 (VDD), IC17.1 (VDD), IC18.13 (VDD); also elsewhere on the board

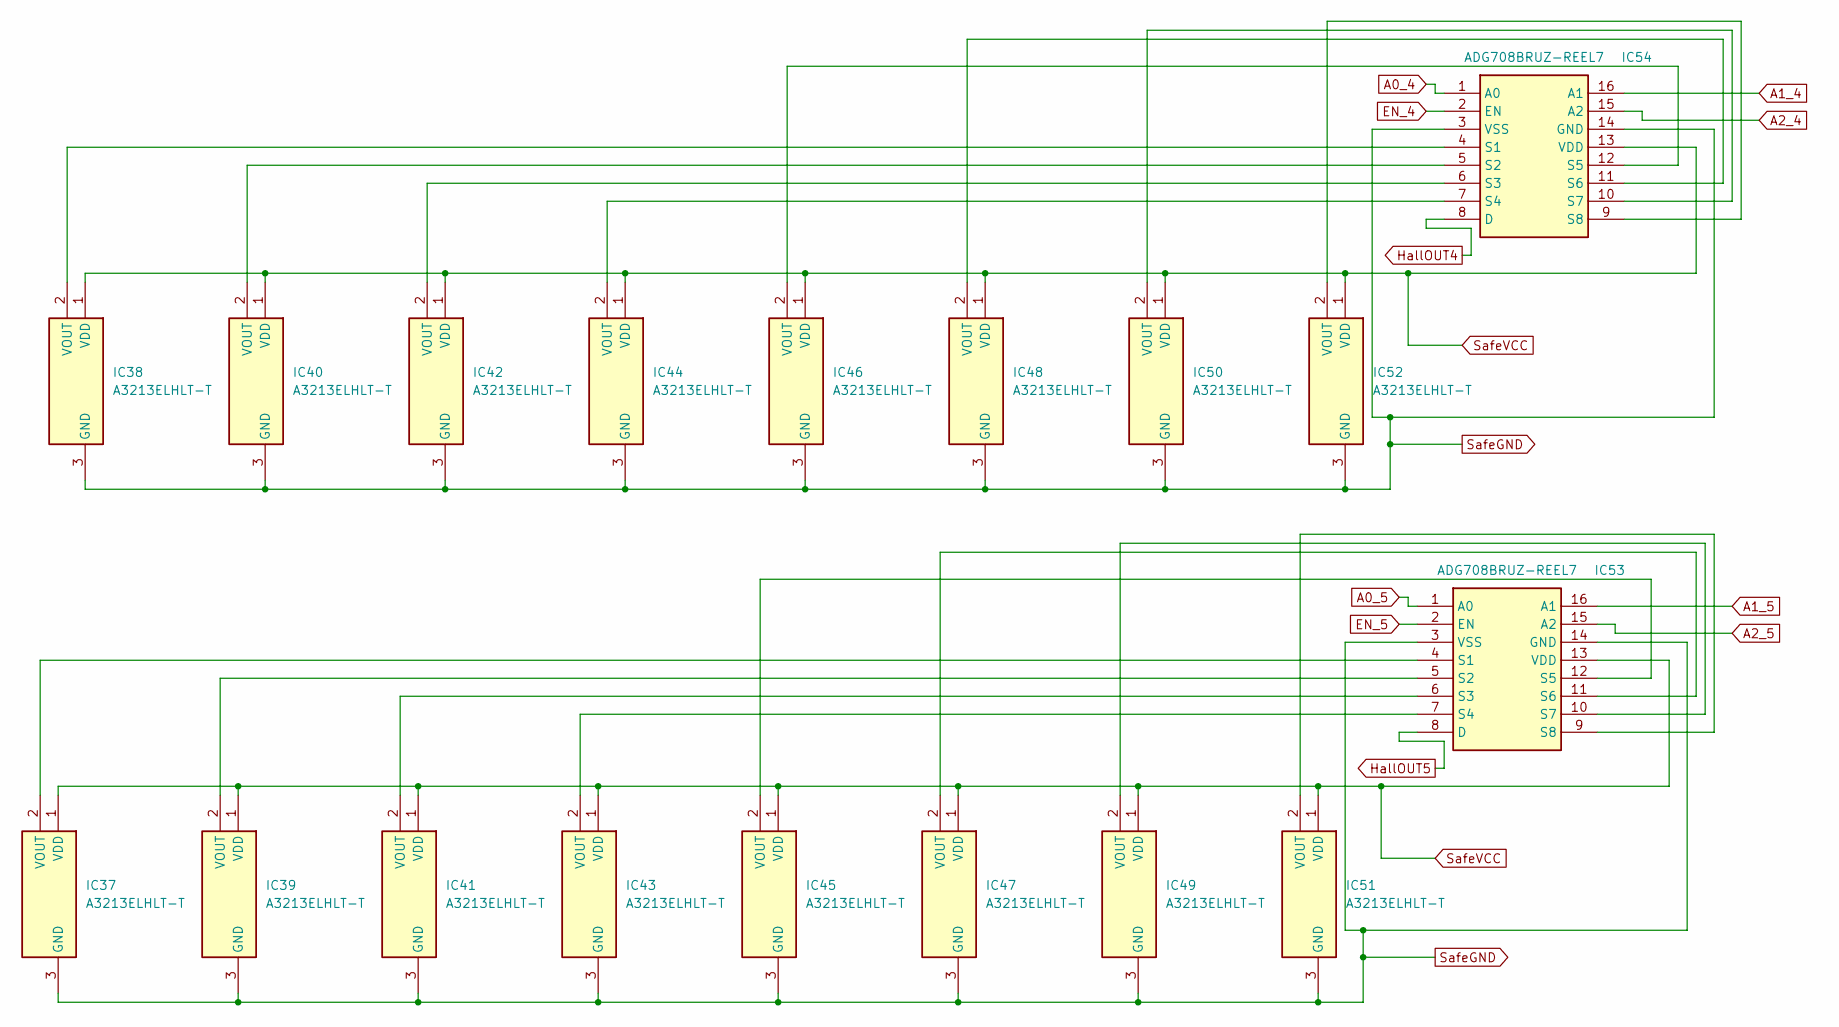
[picture p18: schematic BoardHalls3.kicad_sch, ElectroChessboard]

Parts:
IC37, IC38, IC39, IC40, IC41, IC42, IC43, IC44, IC45, IC46, IC47, IC48, IC49, IC50, IC51, IC52: A3213ELHLT-T; A3213ELHLTT; Mouser Part Number 250-A3213ELHLT-T
IC53, IC54: ADG708BRUZ-REEL7; SOP65P640X120-16N; Mouser Part Number 584-ADG708BRUZ-R7

Connections:
A0_4: IC54.1 (A0); also elsewhere on the board
A0_5: IC53.1 (A0); also elsewhere on the board
A1_4: IC54.16 (A1); also elsewhere on the board
A1_5: IC53.16 (A1); also elsewhere on the board
A2_4: IC54.15 (A2); also elsewhere on the board
A2_5: IC53.15 (A2); also elsewhere on the board
EN_4: IC54.2 (EN); also elsewhere on the board
EN_5: IC53.2 (EN); also elsewhere on the board
HallOUT4: IC54.8 (D); also elsewhere on the board
HallOUT5: IC53.8 (D); also elsewhere on the board
unnamed: IC37.2 (VOUT), IC53.4 (S1)
unnamed: IC38.2 (VOUT), IC54.4 (S1)
unnamed: IC39.2 (VOUT), IC53.5 (S2)
unnamed: IC40.2 (VOUT), IC54.5 (S2)
unnamed: IC41.2 (VOUT), IC53.6 (S3)
unnamed: IC42.2 (VOUT), IC54.6 (S3)
unnamed: IC43.2 (VOUT), IC53.7 (S4)
unnamed: IC44.2 (VOUT), IC54.7 (S4)
unnamed: IC45.2 (VOUT), IC53.12 (S5)
unnamed: IC46.2 (VOUT), IC54.12 (S5)
unnamed: IC47.2 (VOUT), IC53.11 (S6)
unnamed: IC48.2 (VOUT), IC54.11 (S6)
unnamed: IC49.2 (VOUT), IC53.10 (S7)
unnamed: IC50.2 (VOUT), IC54.10 (S7)
unnamed: IC51.2 (VOUT), IC53.9 (S8)
unnamed: IC52.2 (VOUT), IC54.9 (S8)
SafeGND: IC37.3 (GND), IC38.3 (GND), IC39.3 (GND), IC40.3 (GND), IC41.3 (GND), IC42.3 (GND), IC43.3 (GND), IC44.3 (GND), IC45.3 (GND), IC46.3 (GND), IC47.3 (GND), IC48.3 (GND), IC49.3 (GND), IC50.3 (GND), IC51.3 (GND), IC52.3 (GND), IC53.3 (VSS), IC53.14 (GND), IC54.3 (VSS), IC54.14 (GND); also elsewhere on the board
SafeVCC: IC37.1 (VDD), IC38.1 (VDD), IC39.1 (VDD), IC40.1 (VDD), IC41.1 (VDD), IC42.1 (VDD), IC43.1 (VDD), IC44.1 (VDD), IC45.1 (VDD), IC46.1 (VDD), IC47.1 (VDD), IC48.1 (VDD), IC49.1 (VDD), IC50.1 (VDD), IC51.1 (VDD), IC52.1 (VDD), IC53.13 (VDD), IC54.13 (VDD); also elsewhere on the board

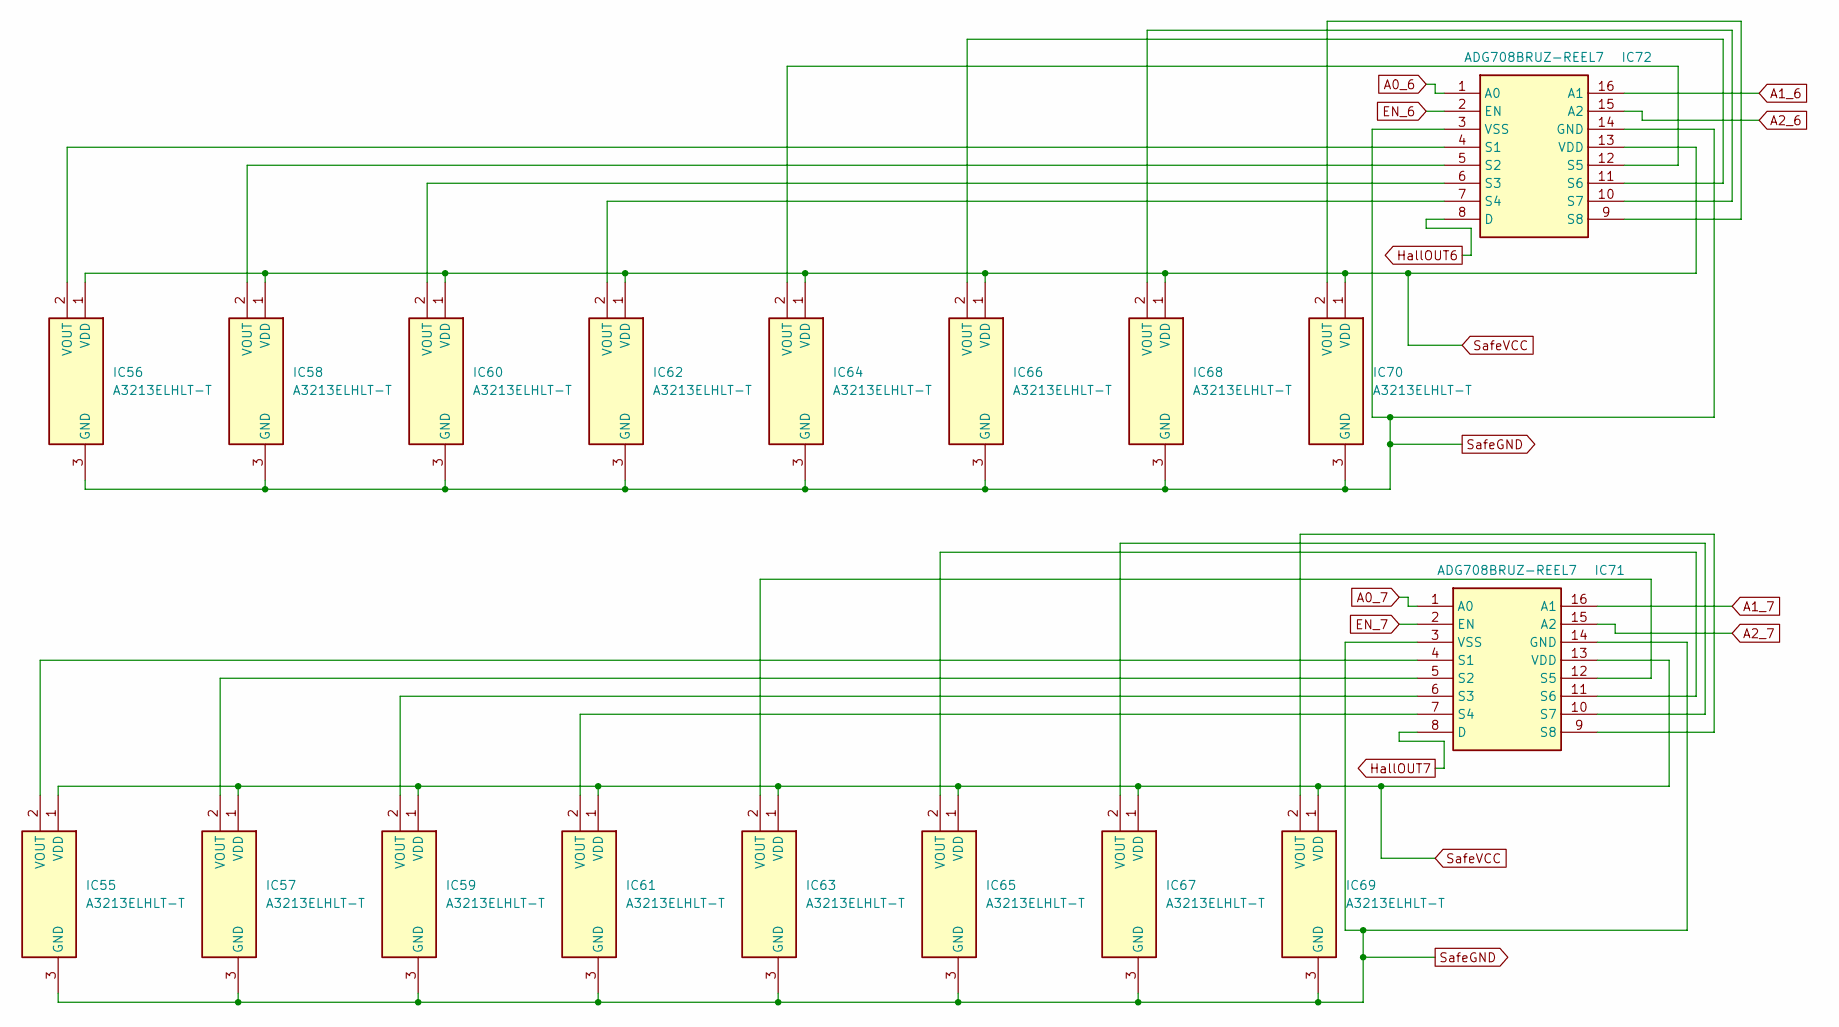
[picture p19: schematic BoardHalls4.kicad_sch, ElectroChessboard]

Parts:
IC55, IC56, IC57, IC58, IC59, IC60, IC61, IC62, IC63, IC64, IC65, IC66, IC67, IC68, IC69, IC70: A3213ELHLT-T; A3213ELHLTT; Mouser Part Number 250-A3213ELHLT-T
IC71, IC72: ADG708BRUZ-REEL7; SOP65P640X120-16N; Mouser Part Number 584-ADG708BRUZ-R7

Connections:
A0_6: IC72.1 (A0); also elsewhere on the board
A0_7: IC71.1 (A0); also elsewhere on the board
A1_6: IC72.16 (A1); also elsewhere on the board
A1_7: IC71.16 (A1); also elsewhere on the board
A2_6: IC72.15 (A2); also elsewhere on the board
A2_7: IC71.15 (A2); also elsewhere on the board
EN_6: IC72.2 (EN); also elsewhere on the board
EN_7: IC71.2 (EN); also elsewhere on the board
HallOUT6: IC72.8 (D); also elsewhere on the board
HallOUT7: IC71.8 (D); also elsewhere on the board
unnamed: IC55.2 (VOUT), IC71.4 (S1)
unnamed: IC56.2 (VOUT), IC72.4 (S1)
unnamed: IC57.2 (VOUT), IC71.5 (S2)
unnamed: IC58.2 (VOUT), IC72.5 (S2)
unnamed: IC59.2 (VOUT), IC71.6 (S3)
unnamed: IC60.2 (VOUT), IC72.6 (S3)
unnamed: IC61.2 (VOUT), IC71.7 (S4)
unnamed: IC62.2 (VOUT), IC72.7 (S4)
unnamed: IC63.2 (VOUT), IC71.12 (S5)
unnamed: IC64.2 (VOUT), IC72.12 (S5)
unnamed: IC65.2 (VOUT), IC71.11 (S6)
unnamed: IC66.2 (VOUT), IC72.11 (S6)
unnamed: IC67.2 (VOUT), IC71.10 (S7)
unnamed: IC68.2 (VOUT), IC72.10 (S7)
unnamed: IC69.2 (VOUT), IC71.9 (S8)
unnamed: IC70.2 (VOUT), IC72.9 (S8)
SafeGND: IC55.3 (GND), IC56.3 (GND), IC57.3 (GND), IC58.3 (GND), IC59.3 (GND), IC60.3 (GND), IC61.3 (GND), IC62.3 (GND), IC63.3 (GND), IC64.3 (GND), IC65.3 (GND), IC66.3 (GND), IC67.3 (GND), IC68.3 (GND), IC69.3 (GND), IC70.3 (GND), IC71.3 (VSS), IC71.14 (GND), IC72.3 (VSS), IC72.14 (GND); also elsewhere on the board
SafeVCC: IC55.1 (VDD), IC56.1 (VDD), IC57.1 (VDD), IC58.1 (VDD), IC59.1 (VDD), IC60.1 (VDD), IC61.1 (VDD), IC62.1 (VDD), IC63.1 (VDD), IC64.1 (VDD), IC65.1 (VDD), IC66.1 (VDD), IC67.1 (VDD), IC68.1 (VDD), IC69.1 (VDD), IC70.1 (VDD), IC71.13 (VDD), IC72.13 (VDD); also elsewhere on the board

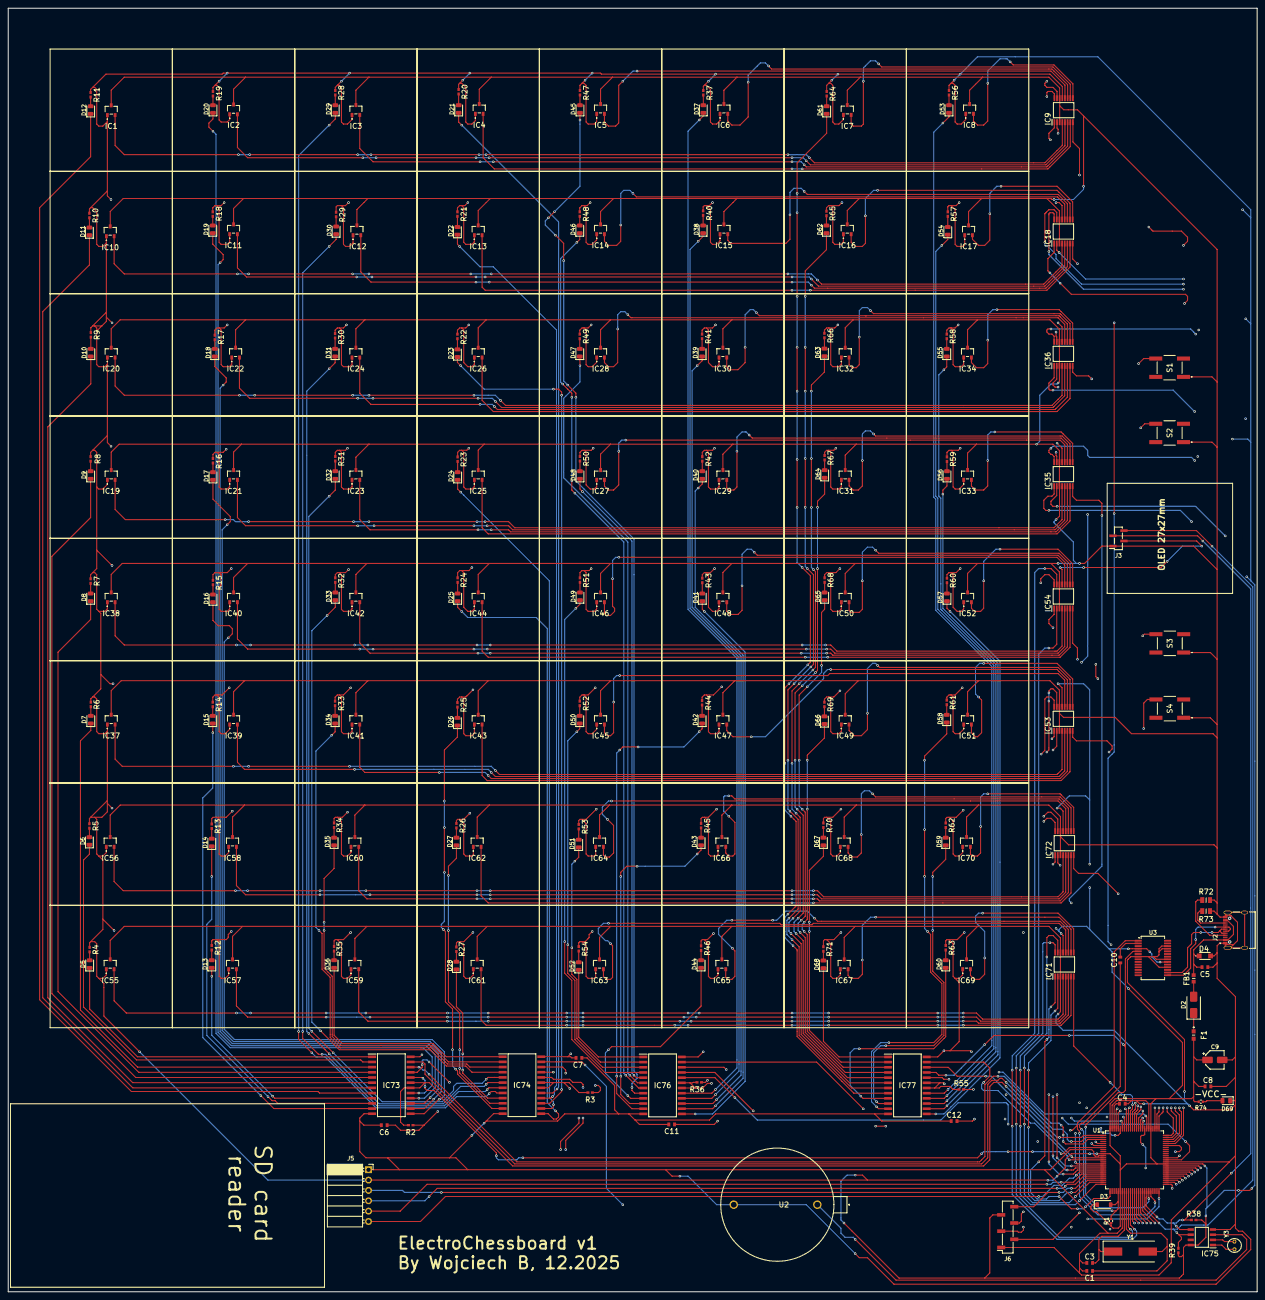
[picture p20: board ElectroChessboard1.kicad_pcb from above]

Board: 4 copper layers, 306.2 x 314.8 mm, 245 parts (0 on the bottom side), 280 nets.
