Wojtekb30/ElectroChessboard/(commit log)

2025-11-09 New project
    Created new, blank project in KiCad for the device
    [ElectroChessboard1.kicad_pcb, ElectroChessboard1.kicad_sch]
2025-11-11 Start + Halls
    Created base + placed all hall sensors
    [BoardHalls2.kicad_sch, BoardHalls3.kicad_sch, BoardHalls4.kicad_sch, BoardLEDs.kicad_sch, ElectroChessboard1.kicad_sch, PowerInput.kicad_sch, board.kicad_sch]
2025-11-12 LEDs added
    Wired Hall sensors and LEDs
    [BoardLEDs2.kicad_sch, ElectroChessboard1.kicad_sch]
2025-11-23 Added but not connected yet SD Card pins and RTC
    .
    [ElectroChessboard1.kicad_pcb, ElectroChessboard1.kicad_sch, PowerInput.kicad_sch]
2025-11-25 Schematic practically done (V0)
    Only requires pin verification and setting footprints.
    PDFs and image added in this commit all come from arduino.cc and microchip.com
    [ElectroChessboard1.kicad_sch]
2025-12-10 Corrected footprints 1
    Chosen footprints for JLCPCB
    I may add USB insterface chip
    [BoardHalls2.kicad_sch, BoardHalls3.kicad_sch, BoardHalls4.kicad_sch, BoardLEDs.kicad_sch, BoardLEDs2.kicad_sch, ElectroChessboard1.kicad_pcb, ElectroChessboard1.kicad_sch, PowerInput.kicad_sch]
2025-12-10 Added FT232RL
    Ready for PCB design
    [ElectroChessboard1.kicad_pcb, ElectroChessboard1.kicad_sch, PowerInput.kicad_sch]
2025-12-10 Chessboard layout
    drawn with silkscreen
    [ElectroChessboard1.kicad_pcb]
2025-12-10 Hall detectors on chessboard
    I put them
    [ElectroChessboard1.kicad_pcb]
2025-12-10 Hall sensors in middle of fields
    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
    [ElectroChessboard1.kicad_pcb]
2025-12-13 Added all LEDs
    Added missing 32 leds
    [BoardLEDs3.kicad_sch, BoardLEDs4.kicad_sch, ElectroChessboard1.kicad_sch]
2025-12-13 Chessboard done
    Other parts left to place. Also, I changed some wiring in schematic, changing what was connected to RX TX1
    [ElectroChessboard1.kicad_pcb, ElectroChessboard1.kicad_sch]
2025-12-13 Added oled
    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
    [ElectroChessboard1.kicad_pcb]
2025-12-13 Fixed pins
    Now footprints of pins match
    [ElectroChessboard1.kicad_pcb, ElectroChessboard1.kicad_sch]
2025-12-13 Big part layout done
    Microcontroller, mux/demux layout and of course wiring left. Also changed footprint of the SD card module pins.
    [ElectroChessboard1.kicad_pcb, ElectroChessboard1.kicad_sch]
2025-12-13 Layout done
    Now wiring is left, and few parts that do not need specific placement
    [ElectroChessboard1.kicad_pcb]
2025-12-14 USB-C
    Changed USB to USB-C and replaced wrong diode, only on schematic
    [PowerInput.kicad_sch]
2025-12-14 Updated PCB
    usb-c
    [ElectroChessboard1.kicad_pcb]
2025-12-14 Chessboard GNDs wired
    Chessboard GNDs wired
    [ElectroChessboard1.kicad_pcb]
2025-12-14 Rotated all LEDs on PCB 180 degrees
    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
    [ElectroChessboard1.kicad_pcb]
2025-12-14 leds positioned
    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
    [ElectroChessboard1.kicad_pcb]
2025-12-14 Wired demuxes to leds
    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
    [ElectroChessboard1.kicad_pcb]
2025-12-14 Muxes and demuxes wired to halls and leds
    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
    [ElectroChessboard1.kicad_pcb]
2025-12-14 Wired power, partially CPU too
    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
    [ElectroChessboard1.kicad_pcb, ElectroChessboard1.kicad_sch]
2025-12-15 4 layers
    Conversion to 4 layers
    [ElectroChessboard1.kicad_pcb]
2025-12-16 Wired VCCs on the chessboard
    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
    [ElectroChessboard1.kicad_pcb]
2025-12-16 Constrains fix
    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
    [ElectroChessboard1.kicad_pcb]
2025-12-16 update
    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
    [ElectroChessboard1.kicad_pcb]
2025-12-16 Major wiring done, only VCCs and GNDs left
    Major wiring done, only VCCs and GNDs left
    [ElectroChessboard1.kicad_pcb]
2025-12-16 update
    27 wiring connections left to make
    [ElectroChessboard1.kicad_pcb]
2025-12-16 Wiring done
    TODO: move silkscreen layers to safety, add power status LED
    [ElectroChessboard1.kicad_pcb]
2025-12-16 Added power status LED
    TODO: Move silkscreen texts out of soldiermasks
    [ElectroChessboard1.kicad_pcb, PowerInput.kicad_sch]
2025-12-19 Corrected silkscreens
    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
    [ElectroChessboard1.kicad_pcb]
2025-12-19 Production files
    For JLCPCB
    [bom.csv, designators.csv, positions.csv]
2026-01-02 Corrected FT-232-RL UART wiring
    I wired RX-TX wrong, which made programming via USB not possible and UART available only with SoftwareSerial. Now I corrected that.
    [ElectroChessboard1.kicad_pcb, PowerInput.kicad_sch]
2026-01-03 Revert last commit
    [ElectroChessboard1.kicad_pcb, PowerInput.kicad_sch]
2026-01-03 New tests
    HALL and RTC
2026-01-03 3D models
    Of chessboard top
    [Board1.stl, BoardBase1.3mf, BoardTop1.stl]
2026-01-05 nowe modele 3d
    [BoardTop1.stl, Piece1.3mf, Piece1.stl]
2026-01-05 SDcardholder model fix
    It had a small defect earlier
    [SDcardHolderTop1.3mf, SDcardHolderTop1.stl]
2026-01-05 Create 16pieces1.stl
    for 3D printing
    [16pieces1.stl]
2026-01-06 Chess icons
    For printing and sticking onto pieces
2026-01-07 Update FinalProgram1.ino
    TODO for now: fix beating opponent's chess figures issues
    [FinalProgram1.ino]
2026-01-10 Update FinalProgram1.ino
    Fixed capture detection logic
    [FinalProgram1.ino]
2026-01-11 SD card support fix
    Fixed SD card support
    [FinalProgram1.ino]
2026-01-11 Added soft reboot
    Watchdog-based, once game ends
    [FinalProgram1.ino]
